HSBL-ko-gyo/WING27/README.md

# WING27

[回路図・PCBをブラウザで見る（KiCanvas）](https://kicanvas.org/?repo=https://github.com/HSBL-ko-gyo/WING27)
