HSBL-ko-gyo/WING27/reference/P2/Wing27_P2_60_key_centers_mm.dxf

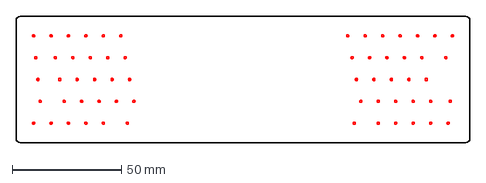
[picture p1: CAD file, 2026-10-17]
reference/P2/Wing27_P2_60_key_centers_mm.dxf
208.0 x 58.0 mm
