HSBL-ko-gyo/WING27/reference/P2/Wing27_P2_reference_plate_T1_D1_60_centers.step

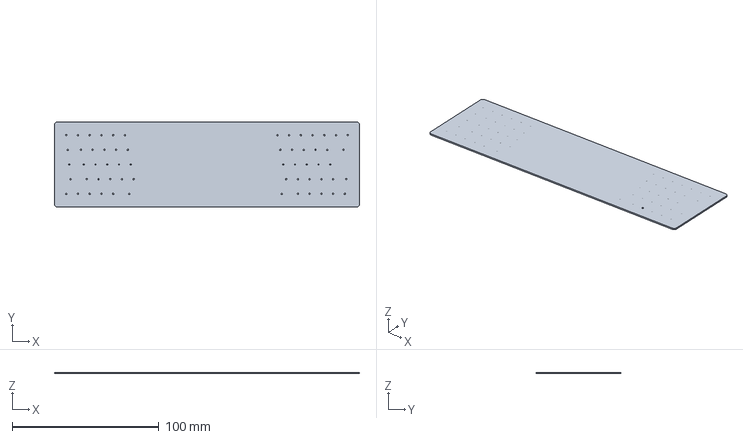
[picture p2: CAD file, 2026-10-17]
reference/P2/Wing27_P2_reference_plate_T1_D1_60_centers.step
208.0 x 58.0 x 1.00 mm
