HSBL-ko-gyo/WING27/WING27.kicad_pcb

## KiCad design WING27.kicad_pcb (2026-10-17)

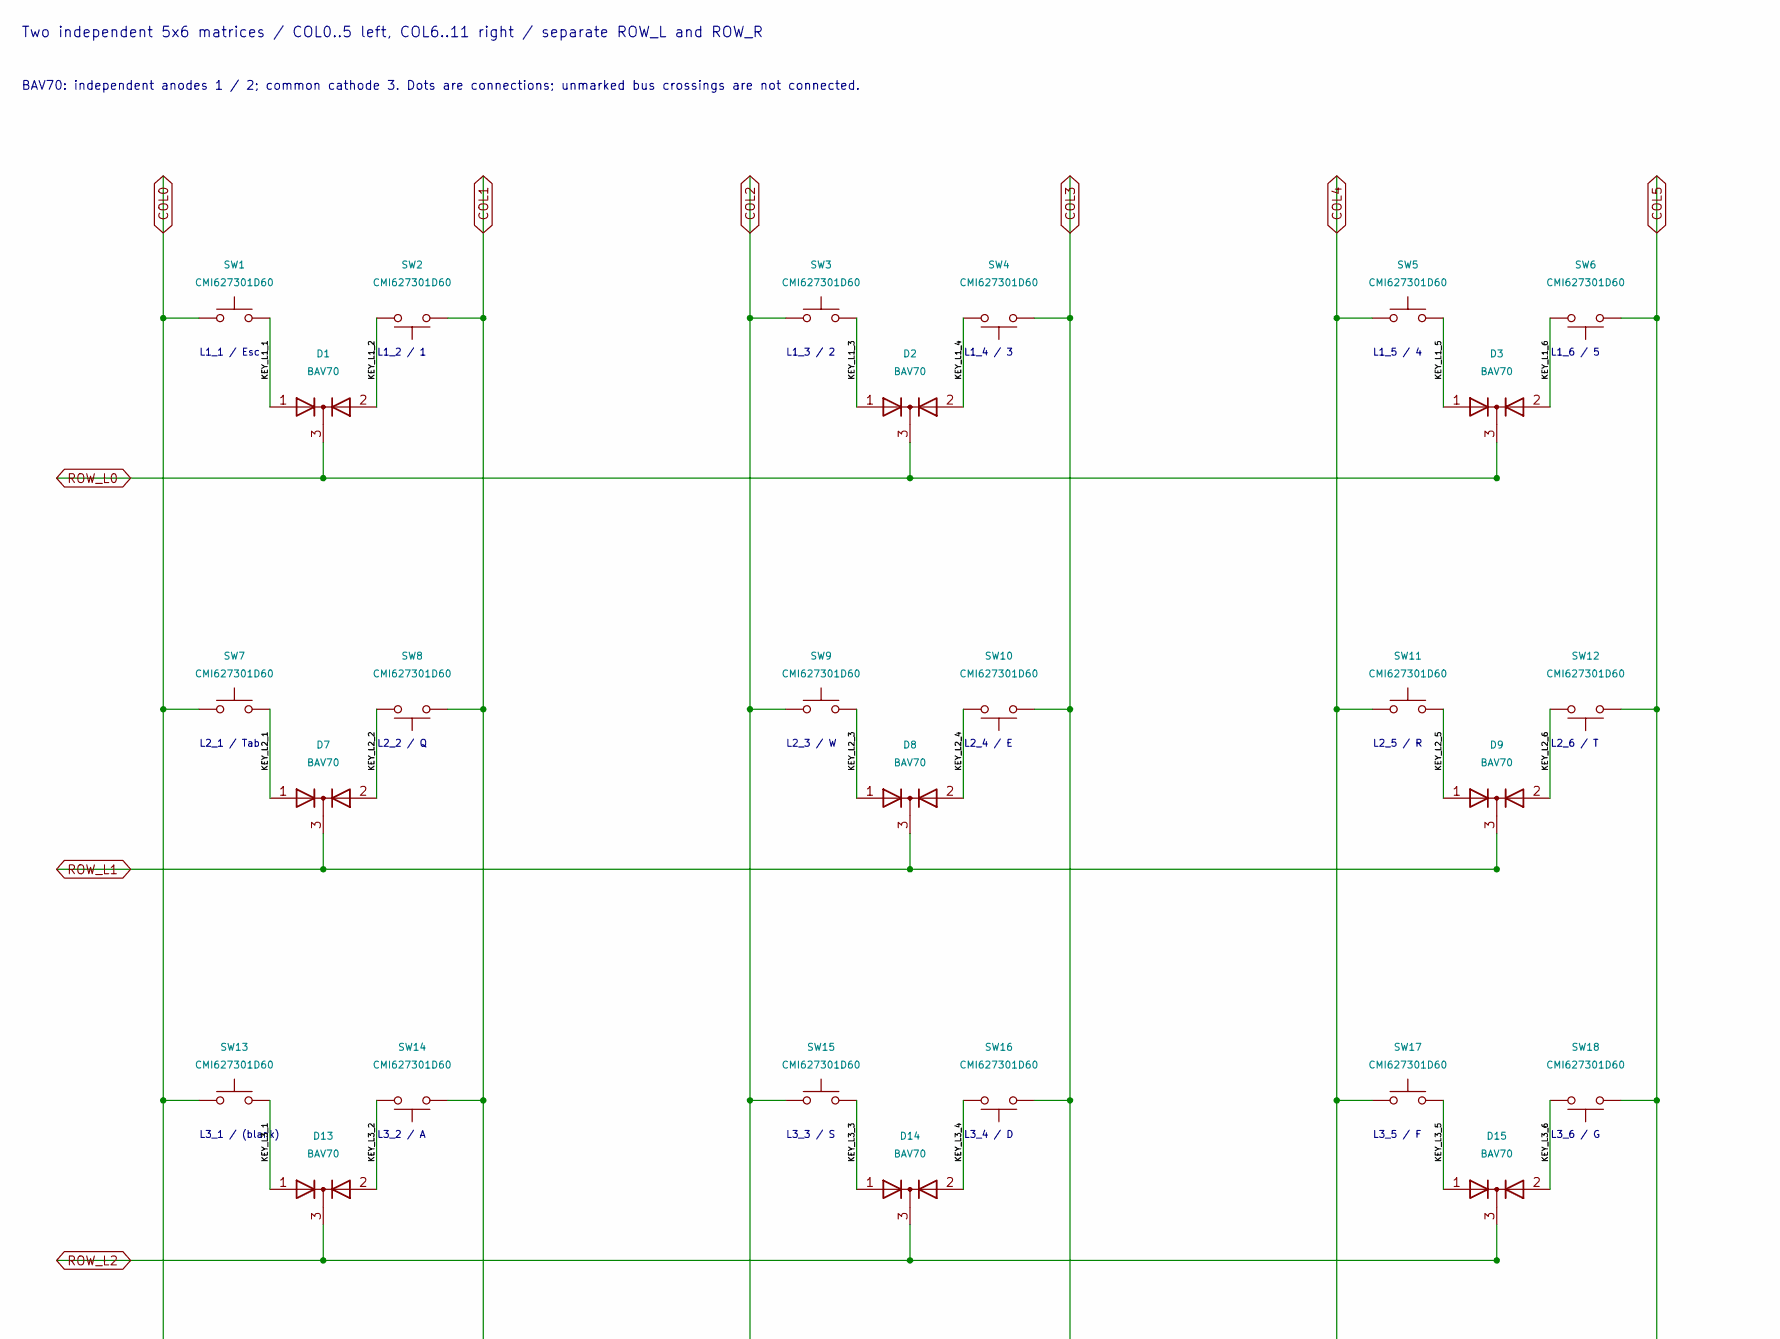
[picture p3: schematic WING27.kicad_sch, WING27 / 60-key matrix, part in row 1, column 1]

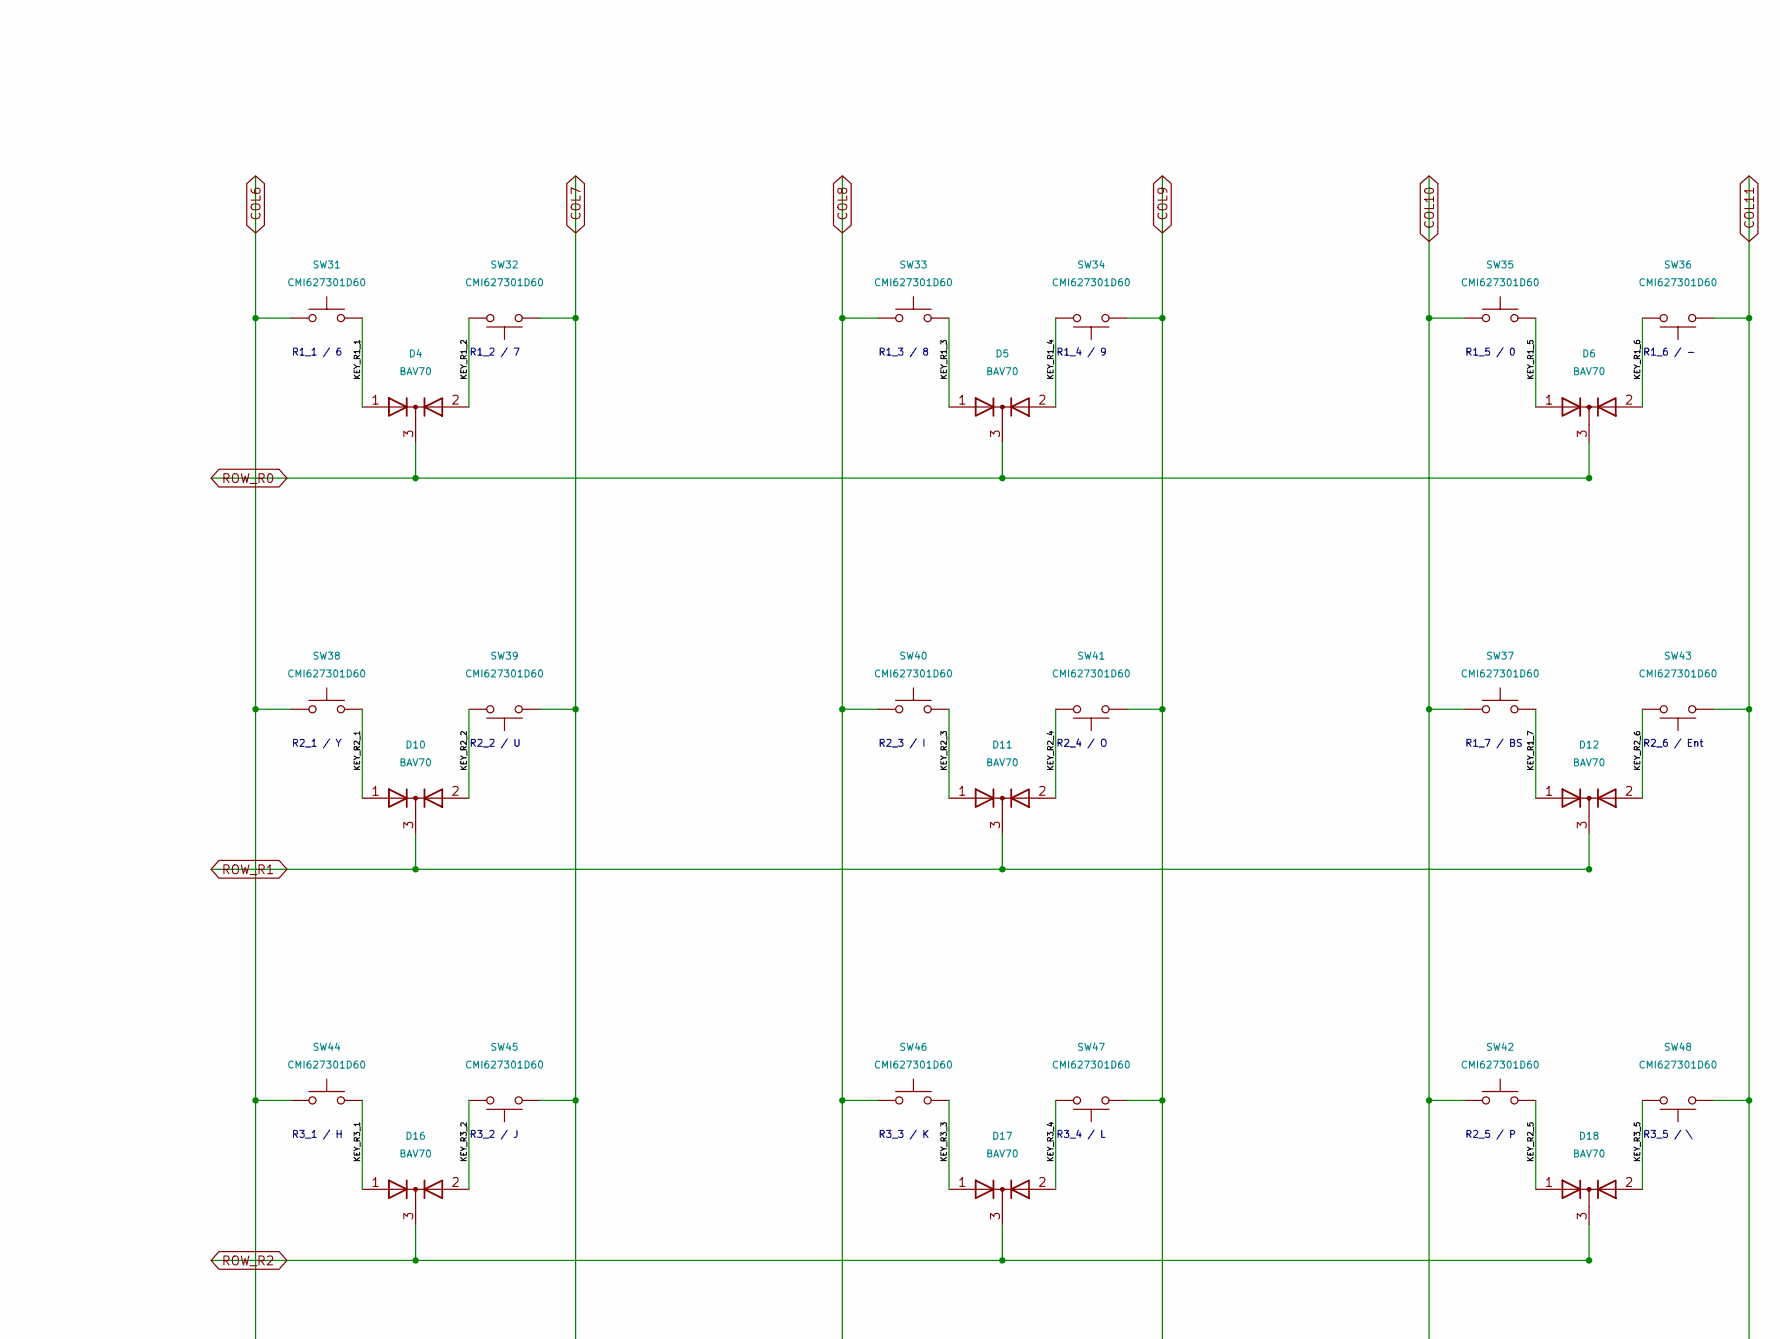
[picture p4: schematic WING27.kicad_sch, WING27 / 60-key matrix, part in row 1, column 2]

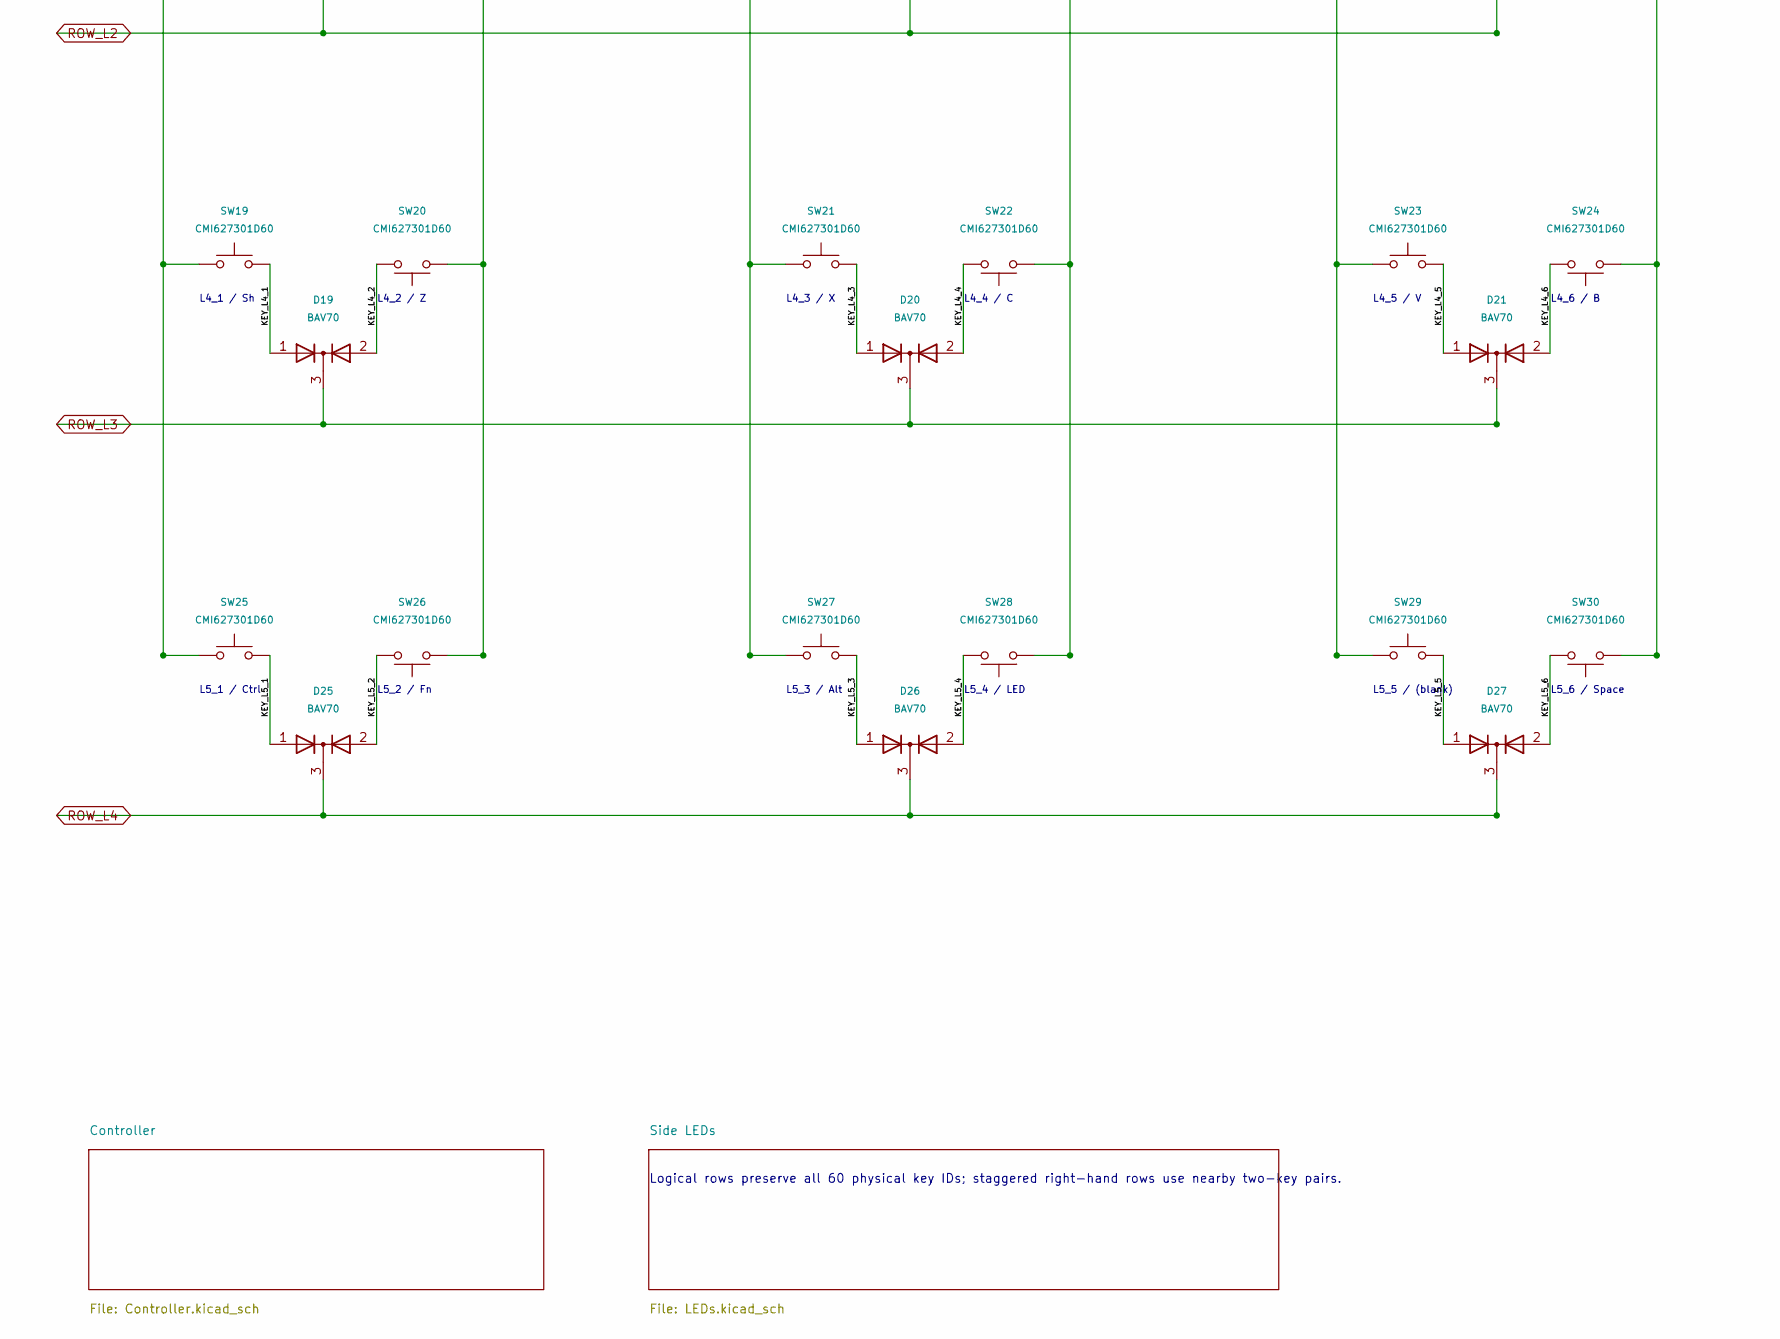
[picture p5: schematic WING27.kicad_sch, WING27 / 60-key matrix, part in row 2, column 1]

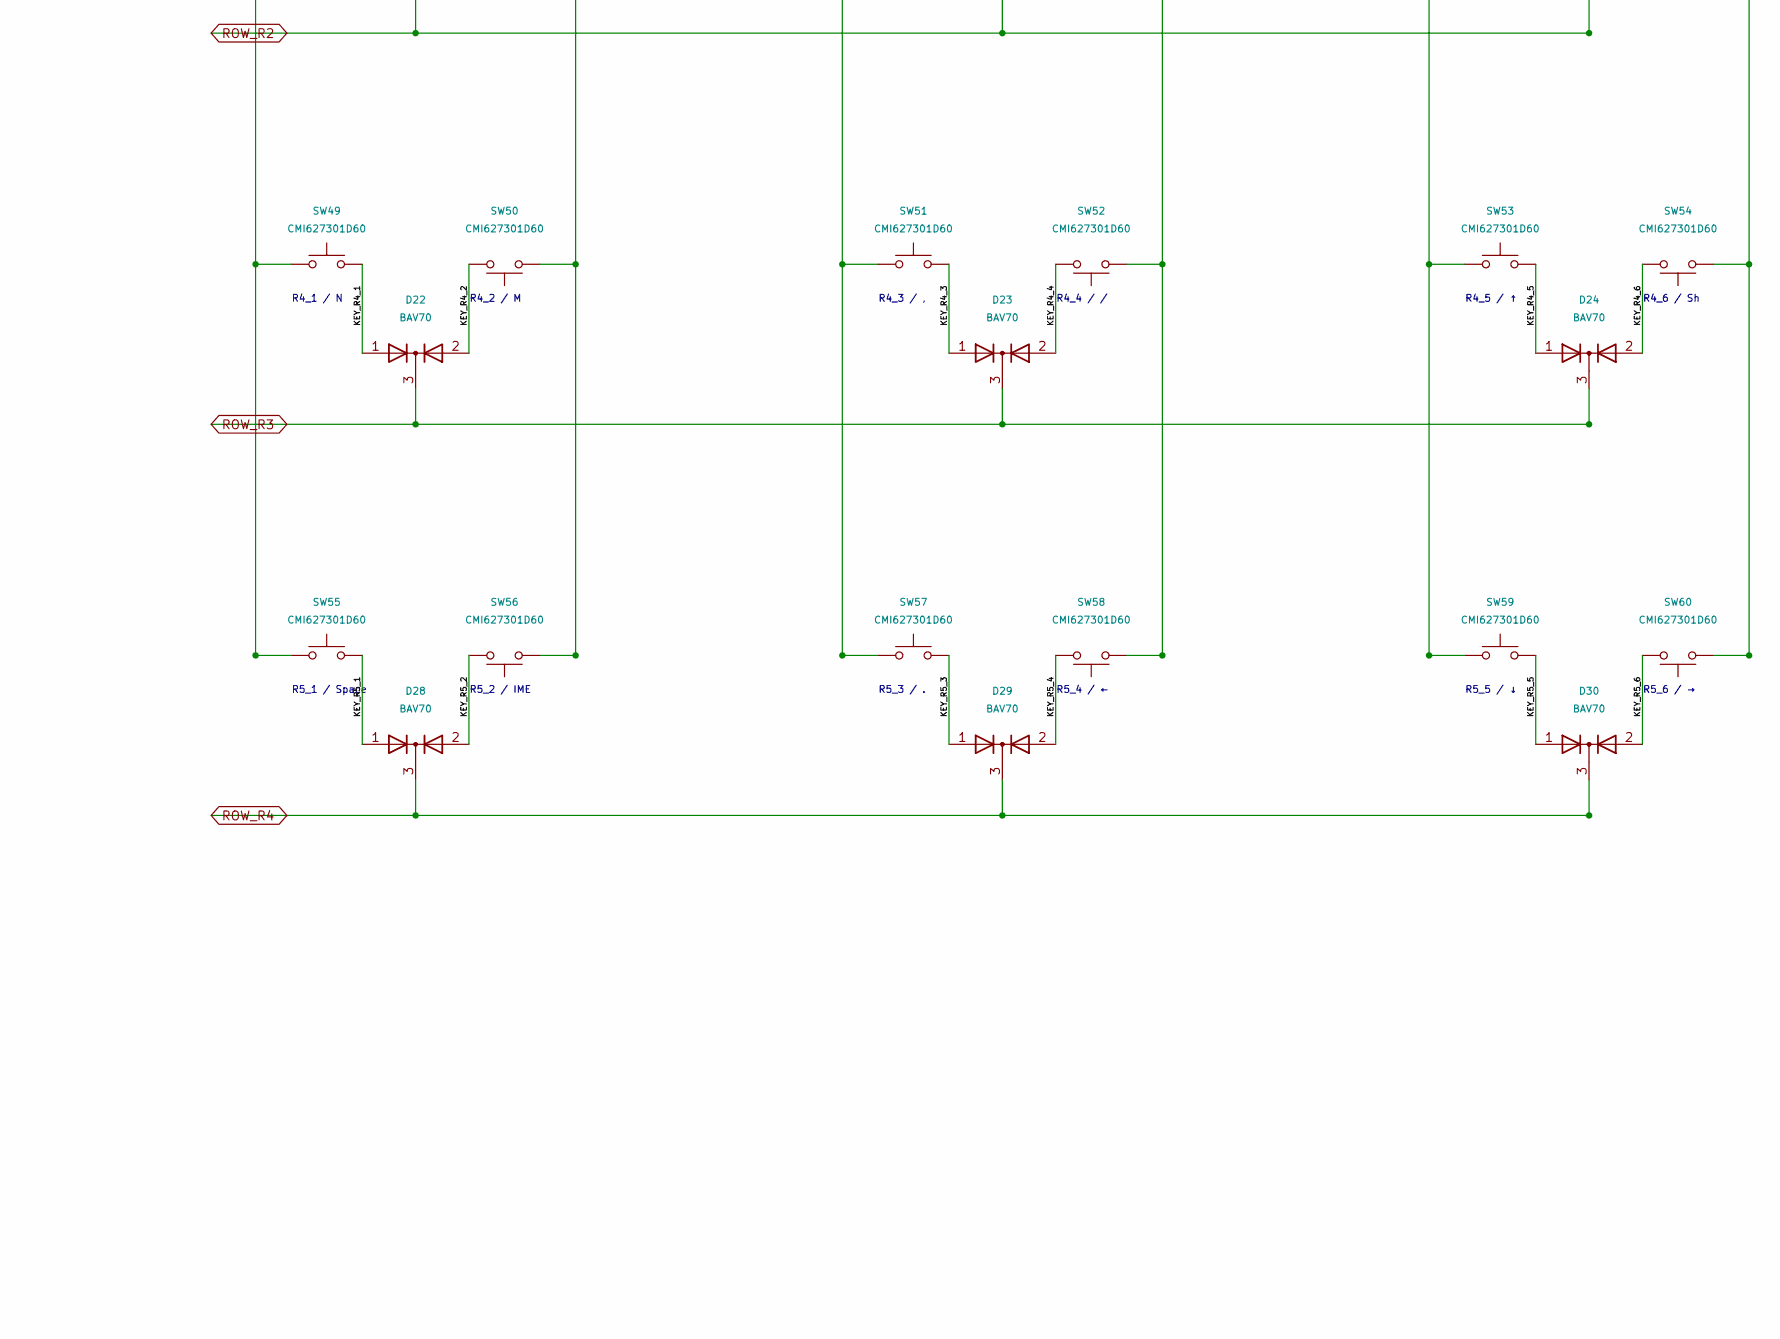
[picture p6: schematic WING27.kicad_sch, WING27 / 60-key matrix, part in row 2, column 2]

Parts:
D1, D2, D3, D4, D5, D6, D7, D8, D9, D10, D11, D12, D13, D14, D15, D16, D17, D18, D19, D20, D21, D22, D23, D24, D25, D26, D27, D28, D29, D30: BAV70; SOT-23; manufacturer_pn BAV70; LCSC C68978
SW1, SW2, SW3, SW4, SW5, SW6, SW7, SW8, SW9, SW10, SW11, SW12, SW13, SW14, SW15, SW16, SW17, SW18, SW19, SW20, SW21, SW22, SW23, SW24, SW25, SW26, SW27, SW28, SW29, SW30, SW31, SW32, SW33, SW34, SW35, SW36, SW37, SW38, SW39, SW40, SW41, SW42, SW43, SW44, SW45, SW46, SW47, SW48, SW49, SW50, SW51, SW52, SW53, SW54, SW55, SW56, SW57, SW58, SW59, SW60: CMI627301D60; Kailh_CMI627301D60; manufacturer_pn CMI627301D60

Connections:
/KEY_L1_1: D1.1 (A), SW1.2
/KEY_L1_2: D1.2 (A), SW2.2
/KEY_L1_3: D2.1 (A), SW3.2
/KEY_L1_4: D2.2 (A), SW4.2
/KEY_L1_5: D3.1 (A), SW5.2
/KEY_L1_6: D3.2 (A), SW6.2
/KEY_L2_1: D7.1 (A), SW7.2
/KEY_L2_2: D7.2 (A), SW8.2
/KEY_L2_3: D8.1 (A), SW9.2
/KEY_L2_4: D8.2 (A), SW10.2
/KEY_L2_5: D9.1 (A), SW11.2
/KEY_L2_6: D9.2 (A), SW12.2
/KEY_L3_1: D13.1 (A), SW13.2
/KEY_L3_2: D13.2 (A), SW14.2
/KEY_L3_3: D14.1 (A), SW15.2
/KEY_L3_4: D14.2 (A), SW16.2
/KEY_L3_5: D15.1 (A), SW17.2
/KEY_L3_6: D15.2 (A), SW18.2
/KEY_L4_1: D19.1 (A), SW19.2
/KEY_L4_2: D19.2 (A), SW20.2
/KEY_L4_3: D20.1 (A), SW21.2
/KEY_L4_4: D20.2 (A), SW22.2
/KEY_L4_5: D21.1 (A), SW23.2
/KEY_L4_6: D21.2 (A), SW24.2
/KEY_L5_1: D25.1 (A), SW25.2
/KEY_L5_2: D25.2 (A), SW26.2
/KEY_L5_3: D26.1 (A), SW27.2
/KEY_L5_4: D26.2 (A), SW28.2
/KEY_L5_5: D27.1 (A), SW29.2
/KEY_L5_6: D27.2 (A), SW30.2
/KEY_R1_1: D4.1 (A), SW31.2
/KEY_R1_2: D4.2 (A), SW32.2
/KEY_R1_3: D5.1 (A), SW33.2
/KEY_R1_4: D5.2 (A), SW34.2
/KEY_R1_5: D6.1 (A), SW35.2
/KEY_R1_6: D6.2 (A), SW36.2
/KEY_R1_7: D12.1 (A), SW37.2
/KEY_R2_1: D10.1 (A), SW38.2
/KEY_R2_2: D10.2 (A), SW39.2
/KEY_R2_3: D11.1 (A), SW40.2
/KEY_R2_4: D11.2 (A), SW41.2
/KEY_R2_5: D18.1 (A), SW42.2
/KEY_R2_6: D12.2 (A), SW43.2
/KEY_R3_1: D16.1 (A), SW44.2
/KEY_R3_2: D16.2 (A), SW45.2
/KEY_R3_3: D17.1 (A), SW46.2
/KEY_R3_4: D17.2 (A), SW47.2
/KEY_R3_5: D18.2 (A), SW48.2
/KEY_R4_1: D22.1 (A), SW49.2
/KEY_R4_2: D22.2 (A), SW50.2
/KEY_R4_3: D23.1 (A), SW51.2
/KEY_R4_4: D23.2 (A), SW52.2
/KEY_R4_5: D24.1 (A), SW53.2
/KEY_R4_6: D24.2 (A), SW54.2
/KEY_R5_1: D28.1 (A), SW55.2
/KEY_R5_2: D28.2 (A), SW56.2
/KEY_R5_3: D29.1 (A), SW57.2
/KEY_R5_4: D29.2 (A), SW58.2
/KEY_R5_5: D30.1 (A), SW59.2
/KEY_R5_6: D30.2 (A), SW60.2
COL0: SW1.1, SW7.1, SW13.1, SW19.1, SW25.1; also elsewhere on the board
COL1: SW2.1, SW8.1, SW14.1, SW20.1, SW26.1; also elsewhere on the board
COL2: SW3.1, SW9.1, SW15.1, SW21.1, SW27.1; also elsewhere on the board
COL3: SW4.1, SW10.1, SW16.1, SW22.1, SW28.1; also elsewhere on the board
COL4: SW5.1, SW11.1, SW17.1, SW23.1, SW29.1; also elsewhere on the board
COL5: SW6.1, SW12.1, SW18.1, SW24.1, SW30.1; also elsewhere on the board
COL6: SW31.1, SW38.1, SW44.1, SW49.1, SW55.1; also elsewhere on the board
COL7: SW32.1, SW39.1, SW45.1, SW50.1, SW56.1; also elsewhere on the board
COL8: SW33.1, SW40.1, SW46.1, SW51.1, SW57.1; also elsewhere on the board
COL9: SW34.1, SW41.1, SW47.1, SW52.1, SW58.1; also elsewhere on the board
COL10: SW35.1, SW37.1, SW42.1, SW53.1, SW59.1; also elsewhere on the board
COL11: SW36.1, SW43.1, SW48.1, SW54.1, SW60.1; also elsewhere on the board
ROW_L0: D1.3 (K), D2.3 (K), D3.3 (K); also elsewhere on the board
ROW_L1: D7.3 (K), D8.3 (K), D9.3 (K); also elsewhere on the board
ROW_L2: D13.3 (K), D14.3 (K), D15.3 (K); also elsewhere on the board
ROW_L3: D19.3 (K), D20.3 (K), D21.3 (K); also elsewhere on the board
ROW_L4: D25.3 (K), D26.3 (K), D27.3 (K); also elsewhere on the board
ROW_R0: D4.3 (K), D5.3 (K), D6.3 (K); also elsewhere on the board
ROW_R1: D10.3 (K), D11.3 (K), D12.3 (K); also elsewhere on the board
ROW_R2: D16.3 (K), D17.3 (K), D18.3 (K); also elsewhere on the board
ROW_R3: D22.3 (K), D23.3 (K), D24.3 (K); also elsewhere on the board
ROW_R4: D28.3 (K), D29.3 (K), D30.3 (K); also elsewhere on the board

Notes on the sheet:
L1_1 / Esc
L1_2 / 1
L1_3 / 2
L1_4 / 3
L1_5 / 4
L1_6 / 5
L2_1 / Tab
L2_2 / Q
L2_3 / W
L2_4 / E
L2_5 / R
L2_6 / T
L3_1 / (blank)
L3_2 / A
L3_3 / S
L3_4 / D
L3_5 / F
L3_6 / G
L4_1 / Sh
L4_2 / Z
L4_3 / X
L4_4 / C
L4_5 / V
L4_6 / B
L5_1 / Ctrl
L5_2 / Fn
L5_3 / Alt
L5_4 / LED
L5_5 / (blank)
L5_6 / Space
R1_1 / 6
R1_2 / 7
R1_3 / 8
R1_4 / 9
R1_5 / 0
R1_6 / -
R1_7 / BS
R2_1 / Y
R2_2 / U
R2_3 / I
R2_4 / O
R2_5 / P
R2_6 / Ent
R3_1 / H
R3_2 / J
R3_3 / K
R3_4 / L
R3_5 / \
R4_1 / N
R4_2 / M
R4_3 / ,
R4_4 / /
R4_5 / ↑
R4_6 / Sh
R5_1 / Space
R5_2 / IME
R5_3 / .
R5_4 / ←
R5_5 / ↓
R5_6 / →
Two independent 5x6 matrices / COL0..5 left, COL6..11 right / separate ROW_L and ROW_R
BAV70: independent anodes 1 / 2; common cathode 3. Dots are connections; unmarked bus crossings are not connected.
Logical rows preserve all 60 physical key IDs; staggered right-hand rows use nearby two-key pairs.

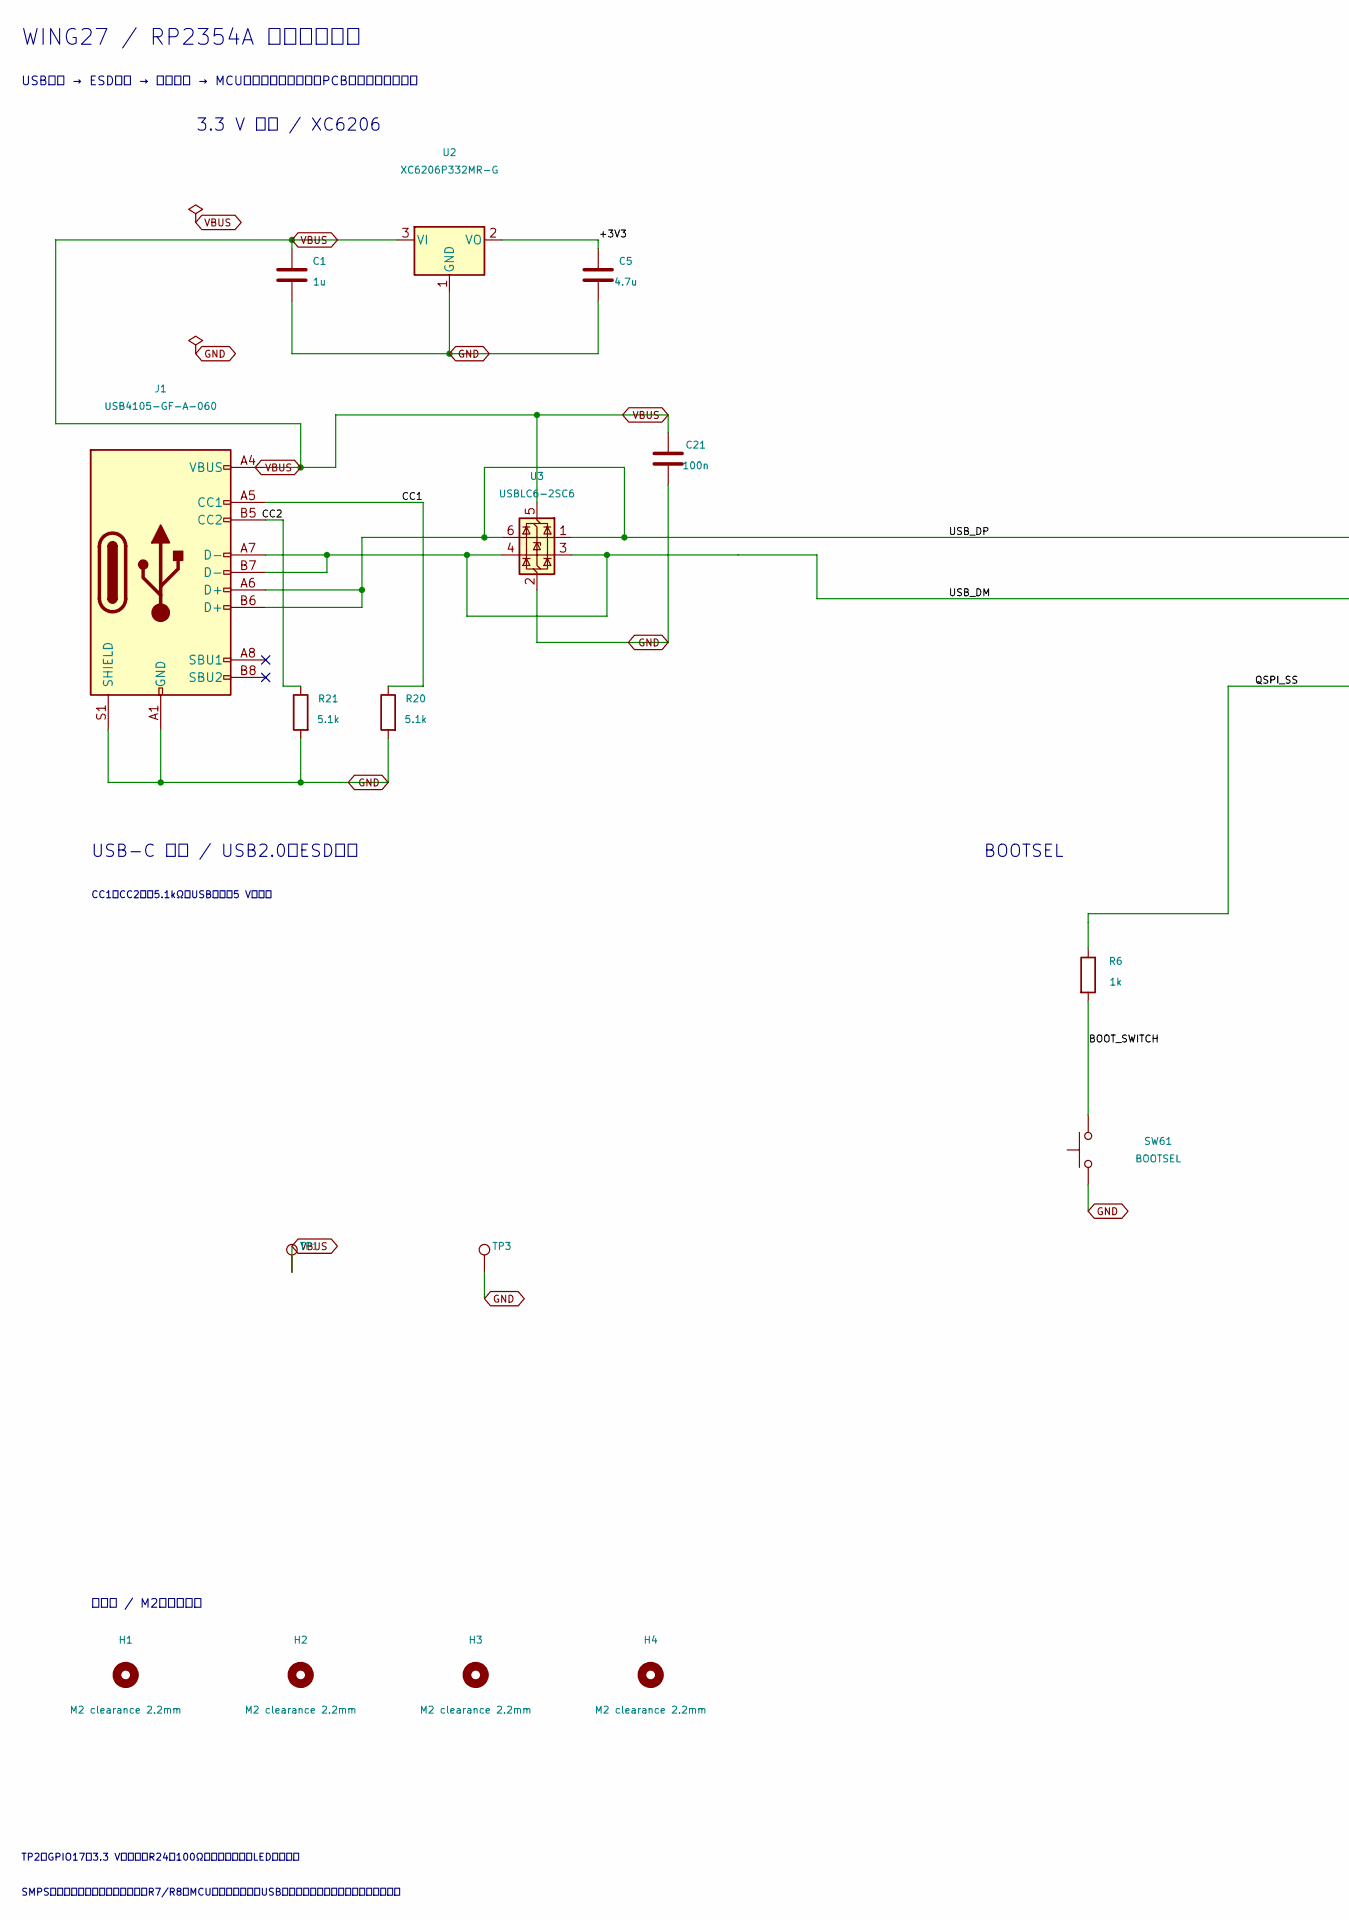
[picture p7: schematic Controller.kicad_sch, WING27 / RP2354A / USB-C controller, part in row 1, column 1]

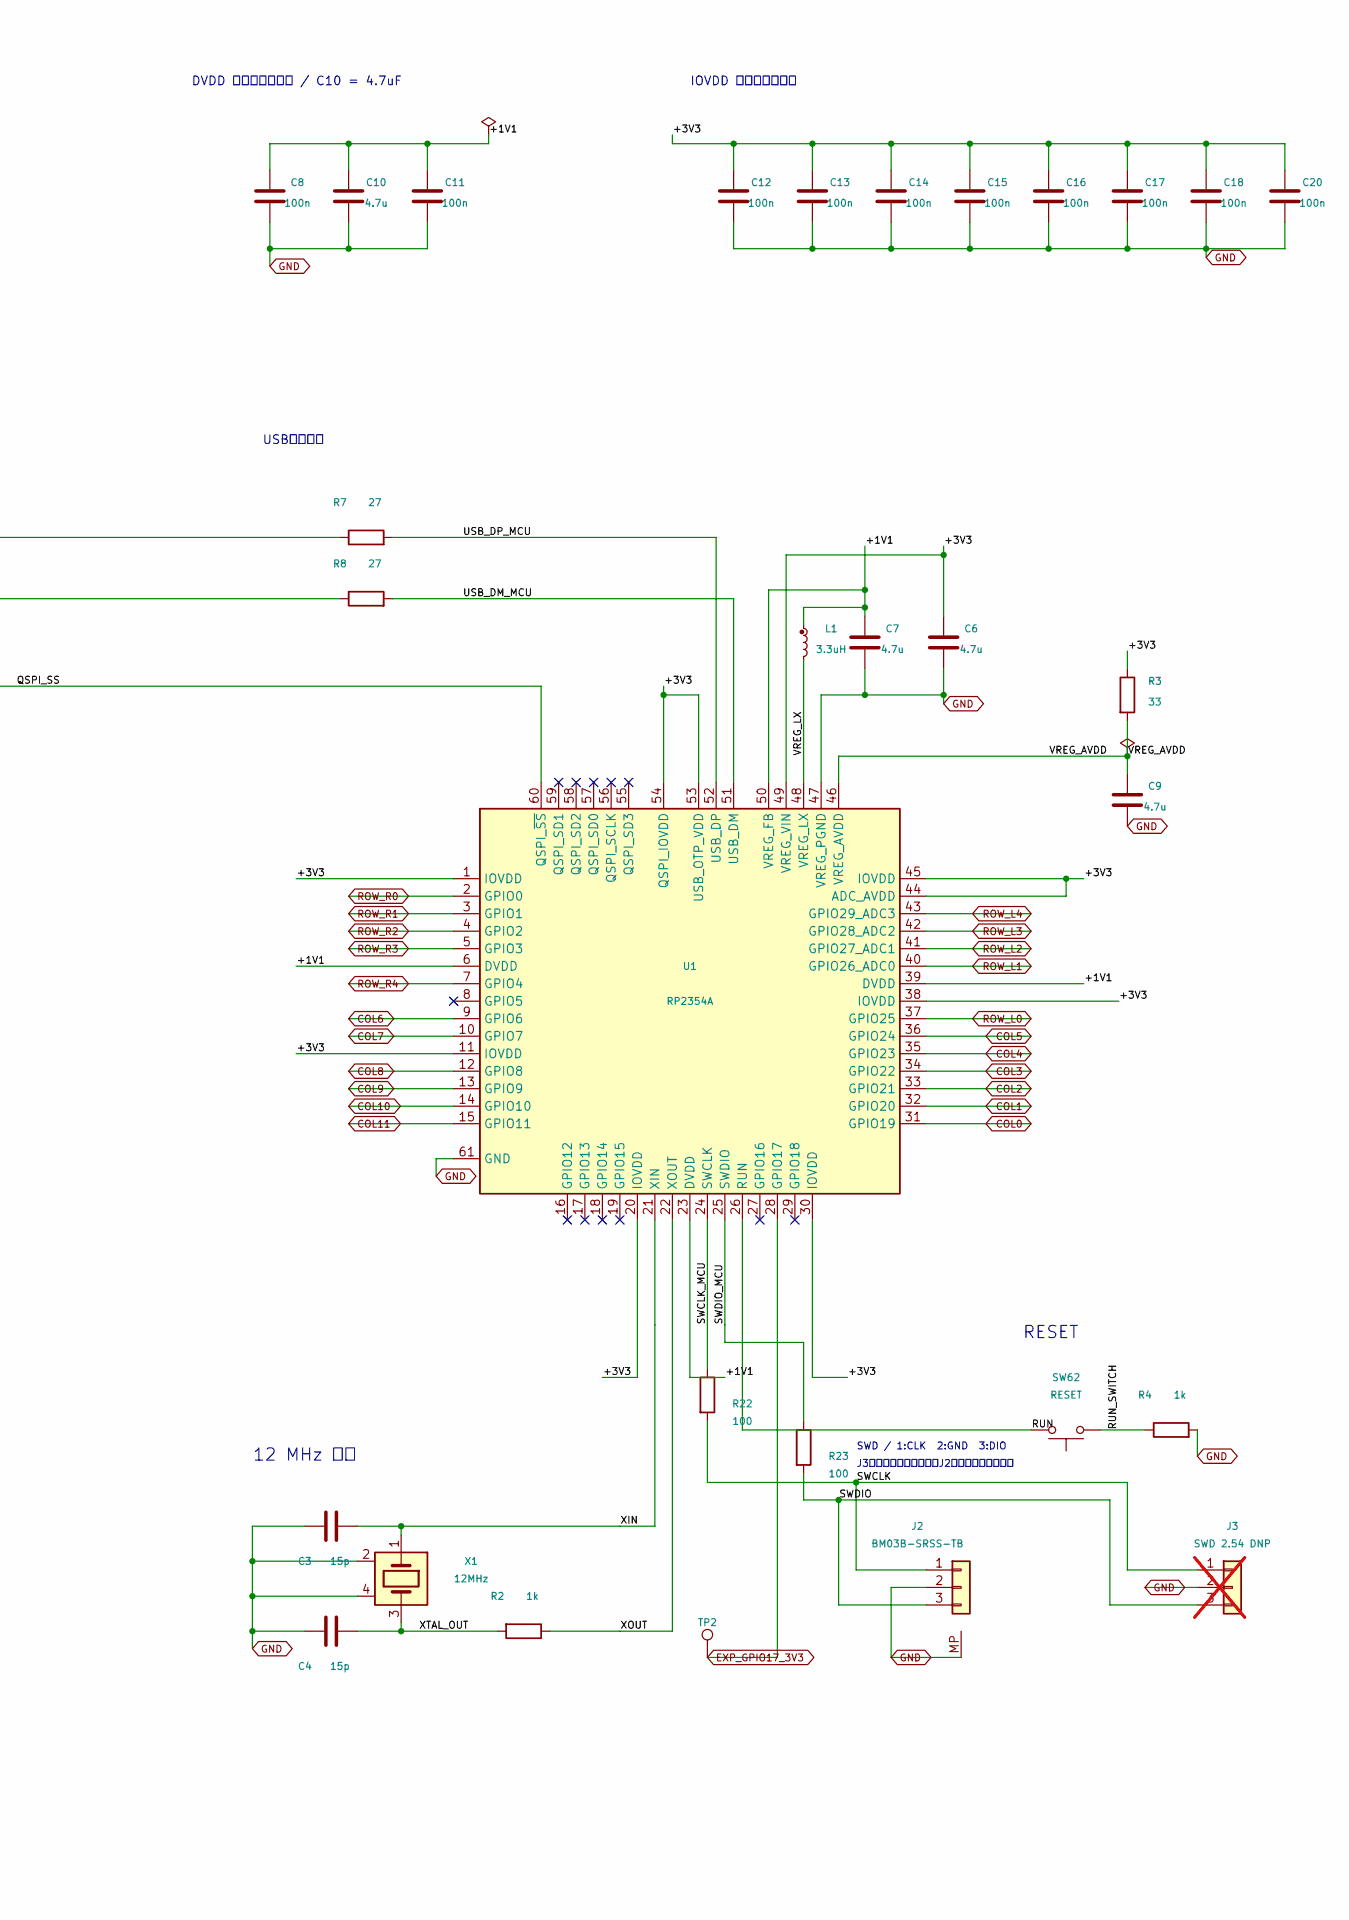
[picture p8: schematic Controller.kicad_sch, WING27 / RP2354A / USB-C controller, part in row 1, column 2]

Parts:
C1: 1u; C_0603_1608Metric; manufacturer_pn CL10A105KB8NNNC; LCSC C15849
C3, C4: 15p; RPI_generic_capc1005x50; voltage 50V; tolerance 5%; manufacturer_pn GRM1555C1H150JA01D
C5: 4.7u; C_0603_1608Metric; manufacturer_pn CL10A475KO8NNNC; LCSC C19666
C6, C7: 4.7u; RPI_generic_capc1005x50_wide; voltage 6.3V; tolerance 20%; manufacturer_pn GRM155R60J475ME47D
C8, C11, C12, C13, C14, C15, C16, C17, C18, C20, C21: 100n; RPI_generic_capc1005x50; voltage 25V; tolerance 10%; manufacturer_pn GRM155R71E104KE14D
C9, C10: 4.7u; RPI_generic_capc1005x50; voltage 6.3V; tolerance 20%; manufacturer_pn GRM155R60J475ME47D
H1, H2, H3, H4: M2 clearance 2.2mm; MountingHole_2.2mm_M2
J1: USB4105-GF-A-060; USB_C_GCT_USB4105_GF_A060_JLC; manufacturer_pn USB4105-GF-A-060; LCSC C3025063
J2: BM03B-SRSS-TB; JST_SH_BM03B-SRSS-TB_1x03-1MP_P1.00mm_Vertical; manufacturer_pn BM03B-SRSS-TB(LF)(SN); LCSC C5306067
J3: SWD 2.54 DNP; PinHeader_1x03_P2.54mm_Vertical; not fitted
L1: 3.3uH; RPI_abracon_aota-b201610s3r3-101-t; tolerance 20%; manufacturer_pn AOTA-B201610S3R3-101-T
R2, R4, R6: 1k; RPI_generic_resc1005x35; tolerance 1%; voltage 50V; manufacturer_pn RC0402FR-071KL
R3: 33; RPI_generic_resc1005x35; tolerance 1%; voltage 50V; manufacturer_pn RC0402FR-0733RL
R7, R8: 27; RPI_generic_resc1005x35; tolerance 1%; voltage 50V; manufacturer_pn RC0402FR-0727RL
R20, R21: 5.1k; RPI_generic_resc1005x35; manufacturer_pn RC0402FR-075K1L
R22, R23: 100; RPI_generic_resc1005x35; manufacturer_pn RC0402FR-07100RL
SW61: BOOTSEL; SW_SPST_TS-1088-AR02016; manufacturer_pn TS-1088-AR02016; LCSC C720477
SW62: RESET; SW_SPST_TS-1088-AR02016; manufacturer_pn TS-1088-AR02016; LCSC C720477
TP1: VBUS; TestPoint_Pad_D1.5mm
TP2: EXP_GPIO17_3V3; TestPoint_Pad_D1.5mm
TP3: GND; TestPoint_Pad_D1.5mm
U1: RP2354A; RPI_rpi_rp2350a_vias; manufacturer_pn RP2354A
U2: XC6206P332MR-G; XC6206_SOT23_Torex_Reference; manufacturer_pn XC6206P332MR-G; LCSC C5446
U3: USBLC6-2SC6; SOT-23-6; manufacturer_pn USBLC6-2SC6; LCSC C7519
X1: 12MHz; RPI_generic_xtalcc320x250x80-4; tolerance 30ppm; manufacturer_pn ABM8-272-T3

Connections:
/Controller/+1V1: C7.1, C8.1, C10.1, C11.1, L1.1, U1.6 (DVDD), U1.23 (DVDD), U1.39 (DVDD), U1.50 (VREG_FB)
/Controller/+3V3: C5.1, C6.1, C12.1, C13.1, C14.1, C15.1, C16.1, C17.1, C18.1, C20.1, R3.1, U1.1 (IOVDD), U1.11 (IOVDD), U1.20 (IOVDD), U1.30 (IOVDD), U1.38 (IOVDD), U1.44 (ADC_AVDD), U1.45 (IOVDD), U1.49 (VREG_VIN), U1.53 (USB_OTP_VDD), U1.54 (QSPI_IOVDD), U2.2 (VO)
/Controller/BOOT_SWITCH: R6.2, SW61.2
/Controller/CC1: J1.A5 (CC1), R20.1
/Controller/CC2: J1.B5 (CC2), R21.1
/Controller/QSPI_SS: R6.1, U1.60 (QSPI_~SS)
/Controller/RUN: SW62.2, U1.26 (RUN)
/Controller/RUN_SWITCH: R4.1, SW62.1
/Controller/SWCLK: J2.1, J3.1, R22.2
/Controller/SWCLK_MCU: R22.1, U1.24 (SWCLK)
/Controller/SWDIO: J2.3, J3.3, R23.2
/Controller/SWDIO_MCU: R23.1, U1.25 (SWDIO)
/Controller/USB_DM: J1.A7 (D-), J1.B7 (D-), R8.1, U3.3 (I/O2), U3.4 (I/O2)
/Controller/USB_DM_MCU: R8.2, U1.51 (USB_DM)
/Controller/USB_DP: J1.A6 (D+), J1.B6 (D+), R7.1, U3.1 (I/O1), U3.6 (I/O1)
/Controller/USB_DP_MCU: R7.2, U1.52 (USB_DP)
/Controller/VREG_AVDD: C9.1, R3.2, U1.46 (VREG_AVDD)
/Controller/VREG_LX: L1.2, U1.48 (VREG_LX)
/Controller/XIN: C3.1, U1.21 (XIN), X1.1
/Controller/XOUT: R2.1, U1.22 (XOUT)
/Controller/XTAL_OUT: C4.1, R2.2, X1.3
COL0: U1.31 (GPIO19); also elsewhere on the board
COL1: U1.32 (GPIO20); also elsewhere on the board
COL2: U1.33 (GPIO21); also elsewhere on the board
COL3: U1.34 (GPIO22); also elsewhere on the board
COL4: U1.35 (GPIO23); also elsewhere on the board
COL5: U1.36 (GPIO24); also elsewhere on the board
COL6: U1.9 (GPIO6); also elsewhere on the board
COL7: U1.10 (GPIO7); also elsewhere on the board
COL8: U1.12 (GPIO8); also elsewhere on the board
COL9: U1.13 (GPIO9); also elsewhere on the board
COL10: U1.14 (GPIO10); also elsewhere on the board
COL11: U1.15 (GPIO11); also elsewhere on the board
EXP_GPIO17_3V3: TP2.1, U1.28 (GPIO17); also elsewhere on the board
GND: C1.2, C3.2, C4.2, C5.2, C6.2, C7.2, C8.2, C9.2, C10.2, C11.2, C12.2, C13.2, C14.2, C15.2, C16.2, C17.2, C18.2, C20.2, C21.2, J1.A1 (GND), J1.A12 (GND), J1.B1 (GND), J1.B12 (GND), J1.S1 (SHIELD), J2.2, J2.MP, J3.2, R4.2, R20.2, R21.2, SW61.1, TP3.1, U1.47 (VREG_PGND), U1.61 (GND), U2.1 (GND), U3.2 (GND), X1.2, X1.4; also elsewhere on the board
ROW_L0: U1.37 (GPIO25); also elsewhere on the board
ROW_L1: U1.40 (GPIO26_ADC0); also elsewhere on the board
ROW_L2: U1.41 (GPIO27_ADC1); also elsewhere on the board
ROW_L3: U1.42 (GPIO28_ADC2); also elsewhere on the board
ROW_L4: U1.43 (GPIO29_ADC3); also elsewhere on the board
ROW_R0: U1.2 (GPIO0); also elsewhere on the board
ROW_R1: U1.3 (GPIO1); also elsewhere on the board
ROW_R2: U1.4 (GPIO2); also elsewhere on the board
ROW_R3: U1.5 (GPIO3); also elsewhere on the board
ROW_R4: U1.7 (GPIO4); also elsewhere on the board
VBUS: C1.1, C21.1, J1.A4 (VBUS), J1.A9 (VBUS), J1.B4 (VBUS), J1.B9 (VBUS), TP1.1, U2.3 (VI), U3.5 (VBUS); also elsewhere on the board

Notes on the sheet:
WING27 / RP2354A コントローラ
USB入力 → ESD保護 → 直列抵抗 → MCU。電気接続・部品・PCB配置は変更なし。
3.3 V 電源 / XC6206
DVDD デカップリング / C10 = 4.7uF
IOVDD デカップリング
USB-C 入力 / USB2.0・ESD保護
CC1・CC2は各5.1kΩ。USB給電は5 Vのみ。
USB直列抵抗
BOOTSEL
12 MHz 水晶
RESET
SWD / 1:CLK 2:GND 3:DIO
J3は未実装の代替端子。J2と同時接続しない。
取付穴 / M2・非めっき
TP2：GPIO17の3.3 Vデータ。R24（100Ω）経由でサイドLEDを駆動。
SMPS・水晶は公式配置関係を維持。R7/R8はMCUの近くに配置。USB・発熱・突入電流は実機検証が必要。
