HSBL-ko-gyo/WING27/WING27.kicad_pcb

## KiCad design WING27.kicad_pcb (continued)

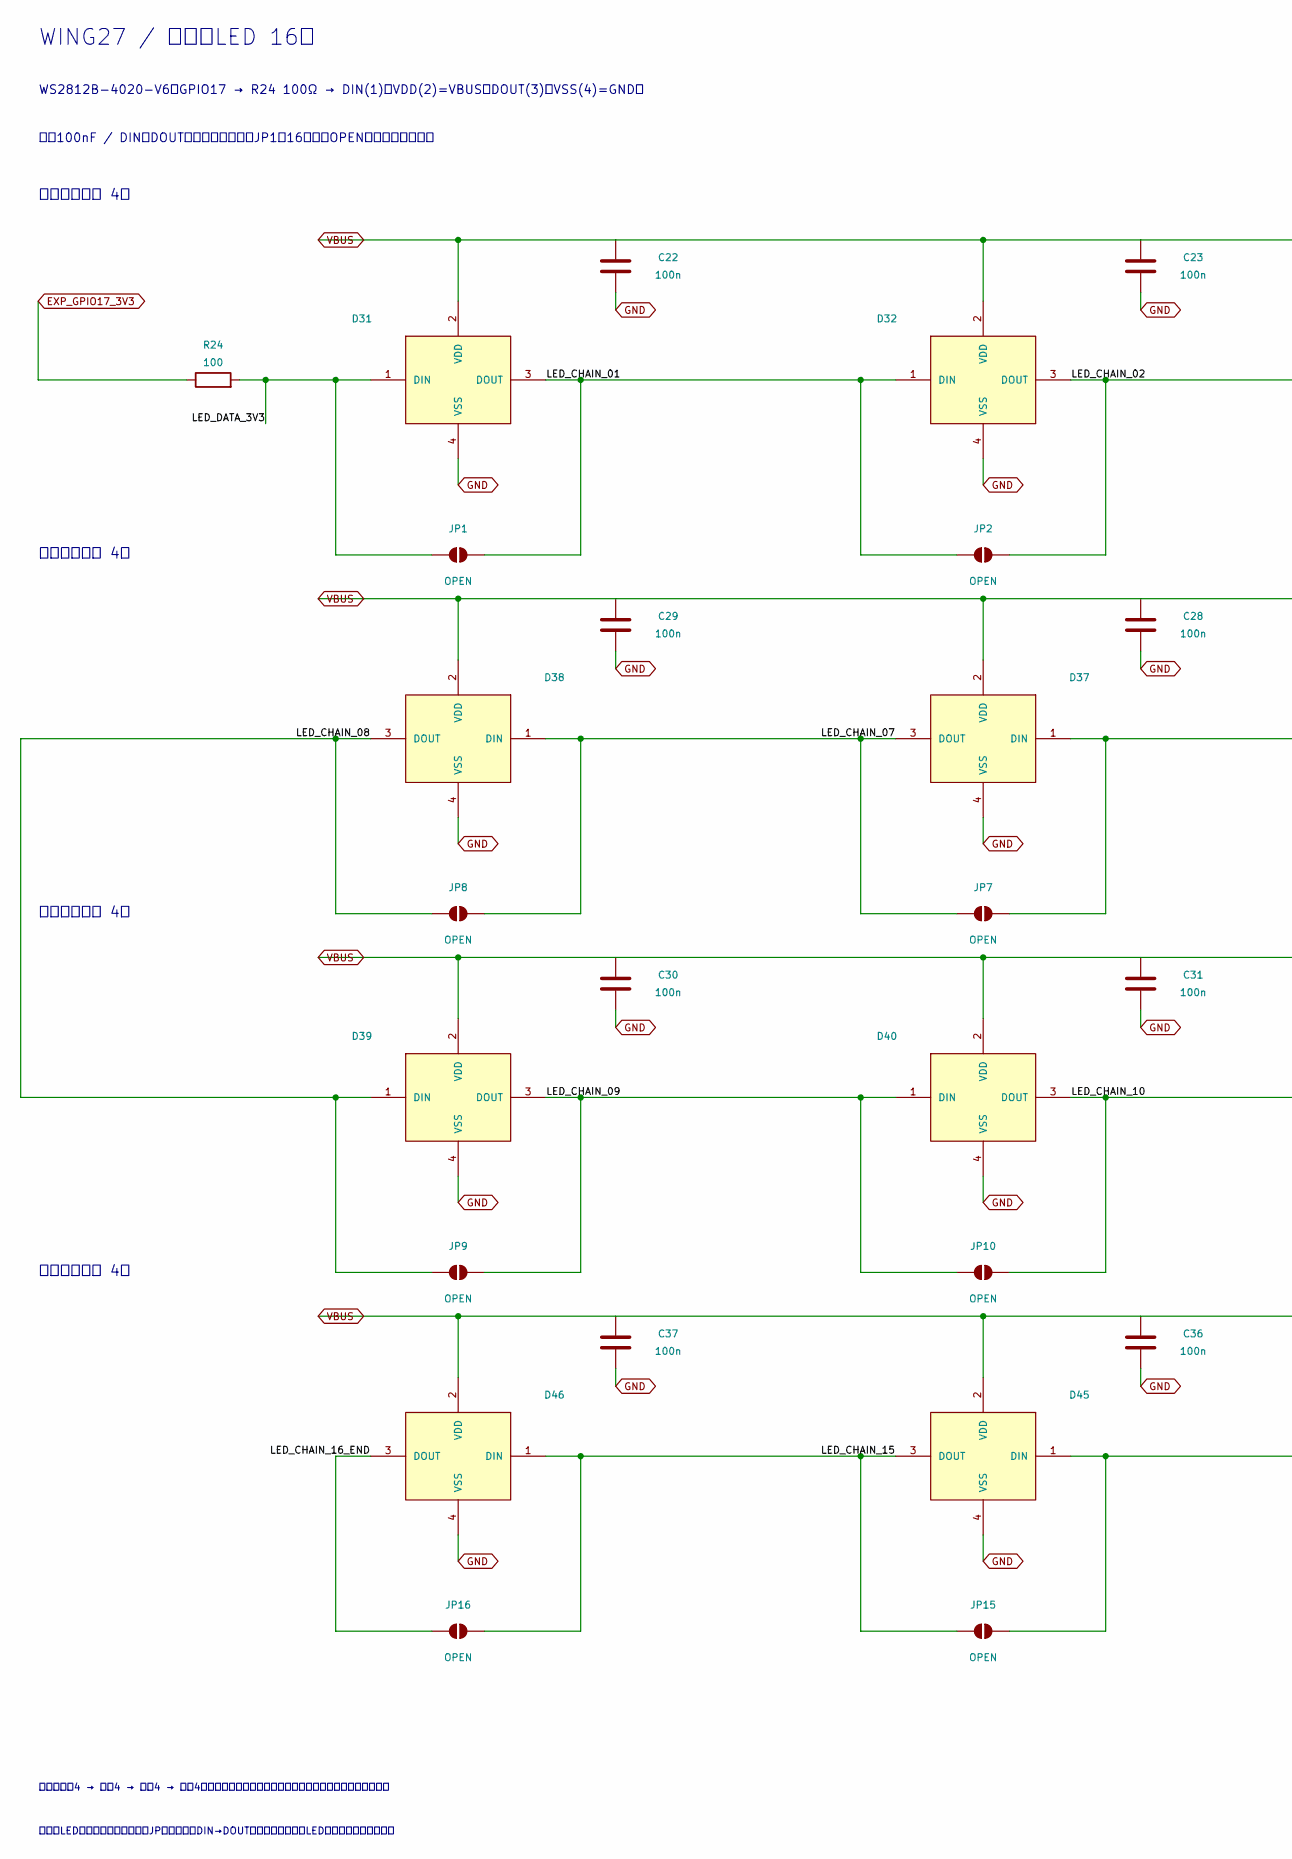
[picture p9: schematic LEDs.kicad_sch, WING27 / サイドLED 16灯, part in row 1, column 1]

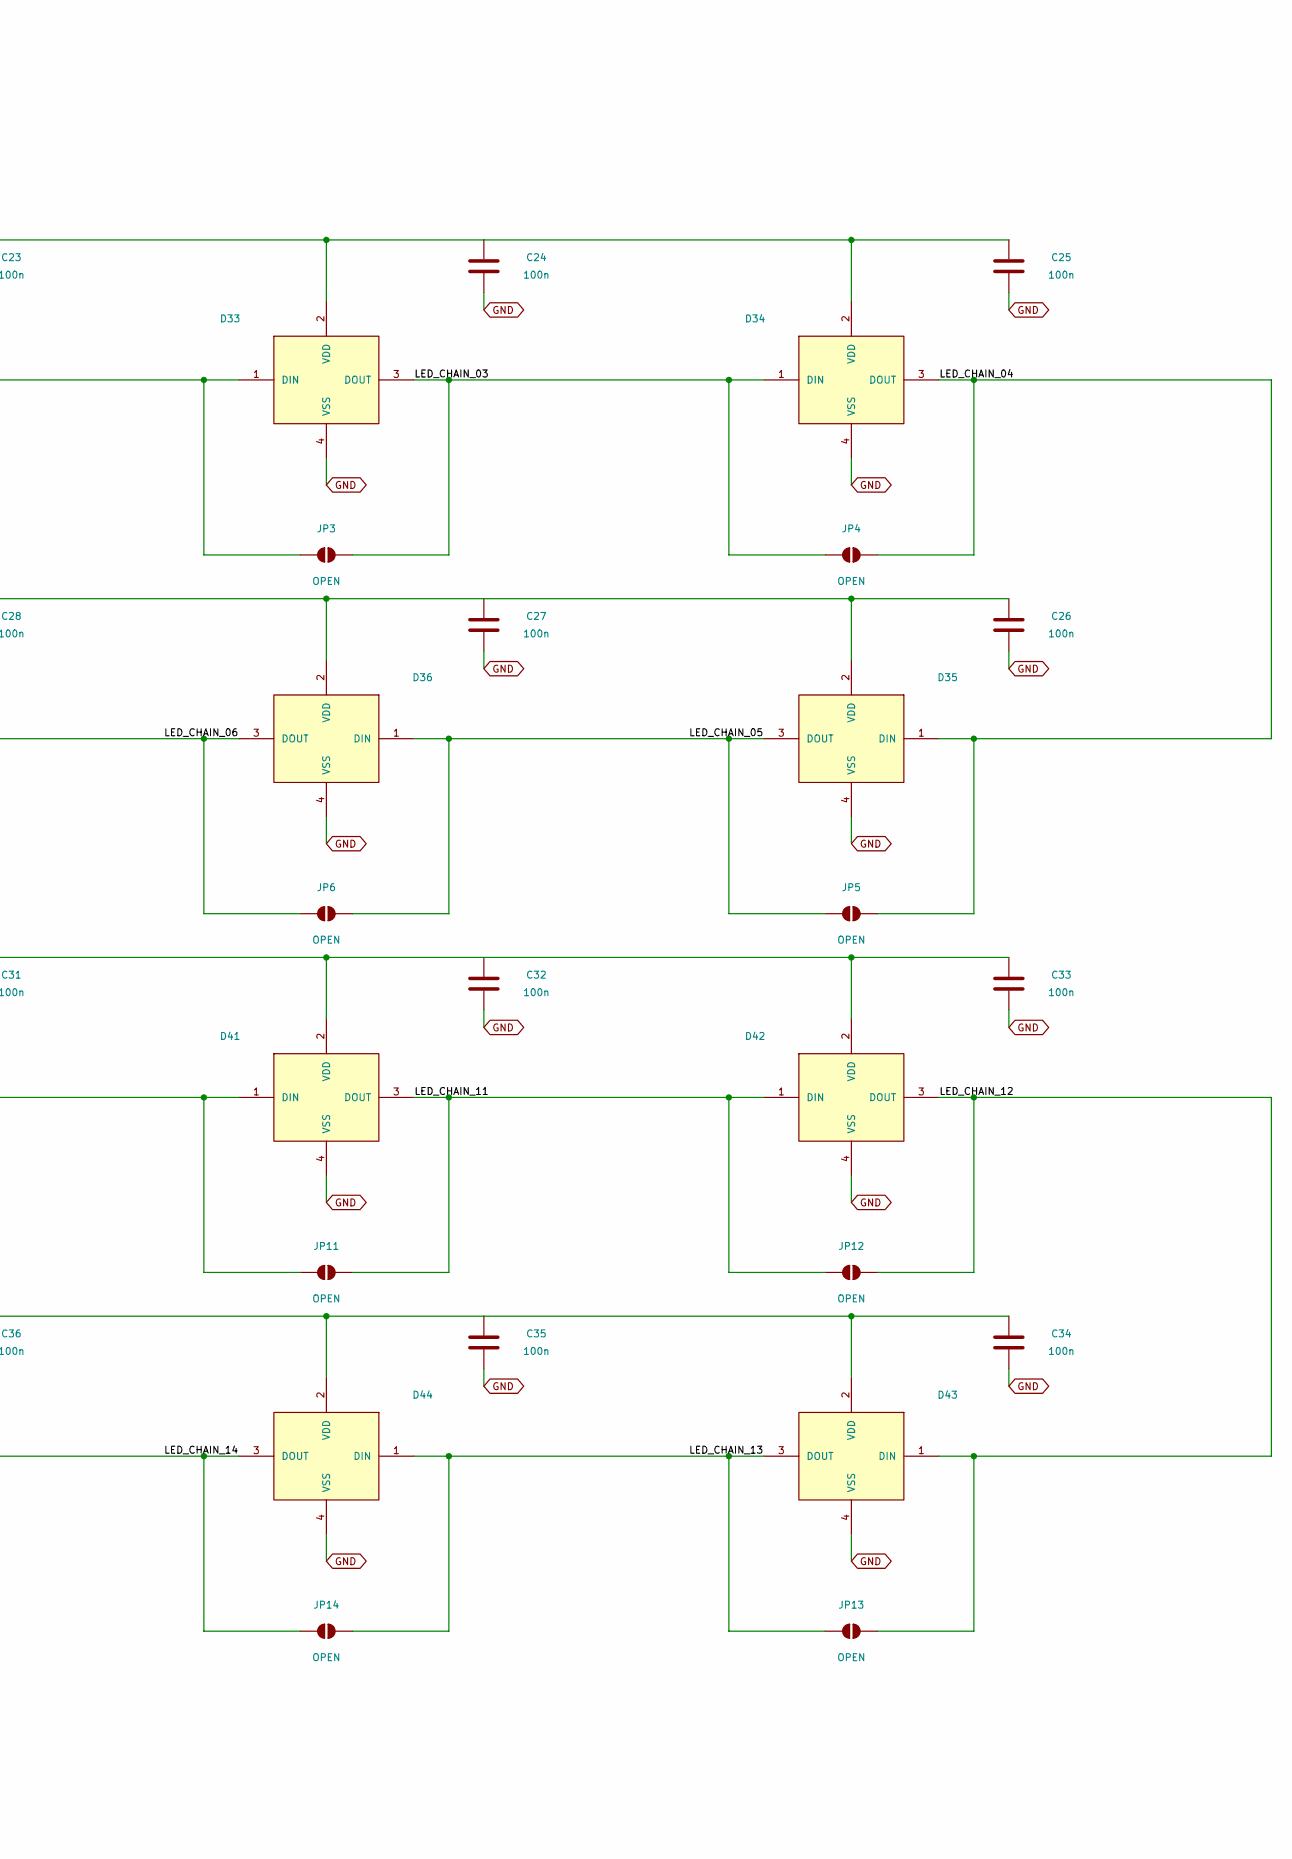
[picture p10: schematic LEDs.kicad_sch, WING27 / サイドLED 16灯, part in row 1, column 2]

Parts:
C22, C23, C24, C25, C26, C27, C28, C29, C30, C31, C32, C33, C34, C35, C36, C37: 100n; RPI_generic_capc1005x50; voltage 25V; tolerance 10%; manufacturer_pn GRM155R71E104KE14D
D31, D32, D33, D34, D35, D36, D37, D38, D39, D40, D41, D42, D43, D44, D45, D46: WS2812B-4020-V6; WS2812B_4020_V6_LCSC_Reference; manufacturer_pn WS2812B-4020-V6; LCSC C52941387
JP1, JP2, JP3, JP4, JP5, JP6, JP7, JP8, JP9, JP10, JP11, JP12, JP13, JP14, JP15, JP16: OPEN; SolderJumper-2_P1.3mm_Open_Pad1.0x1.5mm
R24: 100; RPI_generic_resc1005x35; manufacturer_pn RC0402FR-07100RL

Connections:
/Side LEDs/LED_CHAIN_01: D31.3 (DOUT), D32.1 (DIN), JP1.2 (B), JP2.1 (A)
/Side LEDs/LED_CHAIN_02: D32.3 (DOUT), D33.1 (DIN), JP2.2 (B), JP3.1 (A)
/Side LEDs/LED_CHAIN_03: D33.3 (DOUT), D34.1 (DIN), JP3.2 (B), JP4.1 (A)
/Side LEDs/LED_CHAIN_04: D34.3 (DOUT), D35.1 (DIN), JP4.2 (B), JP5.1 (A)
/Side LEDs/LED_CHAIN_05: D35.3 (DOUT), D36.1 (DIN), JP5.2 (B), JP6.1 (A)
/Side LEDs/LED_CHAIN_06: D36.3 (DOUT), D37.1 (DIN), JP6.2 (B), JP7.1 (A)
/Side LEDs/LED_CHAIN_07: D37.3 (DOUT), D38.1 (DIN), JP7.2 (B), JP8.1 (A)
/Side LEDs/LED_CHAIN_08: D38.3 (DOUT), D39.1 (DIN), JP8.2 (B), JP9.1 (A)
/Side LEDs/LED_CHAIN_09: D39.3 (DOUT), D40.1 (DIN), JP9.2 (B), JP10.1 (A)
/Side LEDs/LED_CHAIN_10: D40.3 (DOUT), D41.1 (DIN), JP10.2 (B), JP11.1 (A)
/Side LEDs/LED_CHAIN_11: D41.3 (DOUT), D42.1 (DIN), JP11.2 (B), JP12.1 (A)
/Side LEDs/LED_CHAIN_12: D42.3 (DOUT), D43.1 (DIN), JP12.2 (B), JP13.1 (A)
/Side LEDs/LED_CHAIN_13: D43.3 (DOUT), D44.1 (DIN), JP13.2 (B), JP14.1 (A)
/Side LEDs/LED_CHAIN_14: D44.3 (DOUT), D45.1 (DIN), JP14.2 (B), JP15.1 (A)
/Side LEDs/LED_CHAIN_15: D45.3 (DOUT), D46.1 (DIN), JP15.2 (B), JP16.1 (A)
/Side LEDs/LED_CHAIN_16_END: D46.3 (DOUT), JP16.2 (B)
/Side LEDs/LED_DATA_3V3: D31.1 (DIN), JP1.1 (A), R24.2
EXP_GPIO17_3V3: R24.1; also elsewhere on the board
GND: C22.2, C23.2, C24.2, C25.2, C26.2, C27.2, C28.2, C29.2, C30.2, C31.2, C32.2, C33.2, C34.2, C35.2, C36.2, C37.2, D31.4 (VSS), D32.4 (VSS), D33.4 (VSS), D34.4 (VSS), D35.4 (VSS), D36.4 (VSS), D37.4 (VSS), D38.4 (VSS), D39.4 (VSS), D40.4 (VSS), D41.4 (VSS), D42.4 (VSS), D43.4 (VSS), D44.4 (VSS), D45.4 (VSS), D46.4 (VSS); also elsewhere on the board
VBUS: C22.1, C23.1, C24.1, C25.1, C26.1, C27.1, C28.1, C29.1, C30.1, C31.1, C32.1, C33.1, C34.1, C35.1, C36.1, C37.1, D31.2 (VDD), D32.2 (VDD), D33.2 (VDD), D34.2 (VDD), D35.2 (VDD), D36.2 (VDD), D37.2 (VDD), D38.2 (VDD), D39.2 (VDD), D40.2 (VDD), D41.2 (VDD), D42.2 (VDD), D43.2 (VDD), D44.2 (VDD), D45.2 (VDD), D46.2 (VDD); also elsewhere on the board

Notes on the sheet:
左側・内向き 4灯
左側・外向き 4灯
右側・内向き 4灯
右側・外向き 4灯
WING27 / サイドLED 16灯
WS2812B-4020-V6：GPIO17 → R24 100Ω → DIN(1)。VDD(2)=VBUS、DOUT(3)、VSS(4)=GND。
各灯100nF / DIN・DOUTは実配線で連鎖。JP1〜16は通常OPEN、部品実装不要。
順序：左内4 → 左外4 → 右内4 → 右外4。図の左右は信号順を示す。基板の光向きは実装図で確認。
途中のLEDを外す場合のみ、対応JPを短絡してDIN→DOUTをバイパスする。LED実装中は短絡しない。

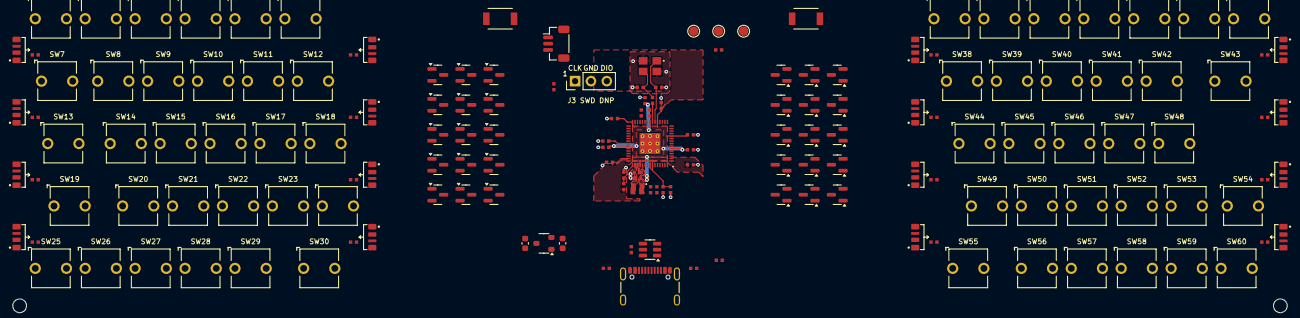
[picture p11: board WING27.kicad_pcb from above]

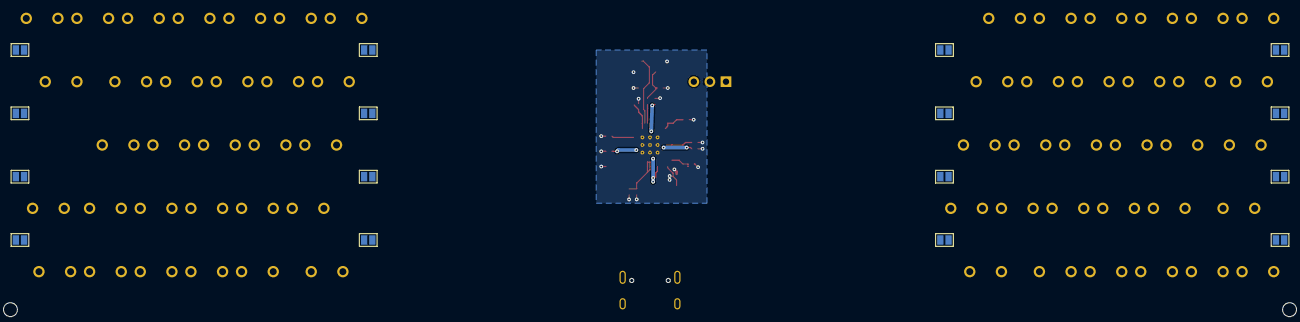
[picture p12: board WING27.kicad_pcb from below]

Board: 2 copper layers, 185 parts (16 on the bottom side), 123 nets.
