HSBL-ko-gyo/WING27/reference/RaspberryPi/RPI-RP2350A-MINIMAL_R4-S1.kicad_pcb

## KiCad design reference/RaspberryPi/RPI-RP2350A-MINIMAL_R4-S1.kicad_pcb (2026-10-17)

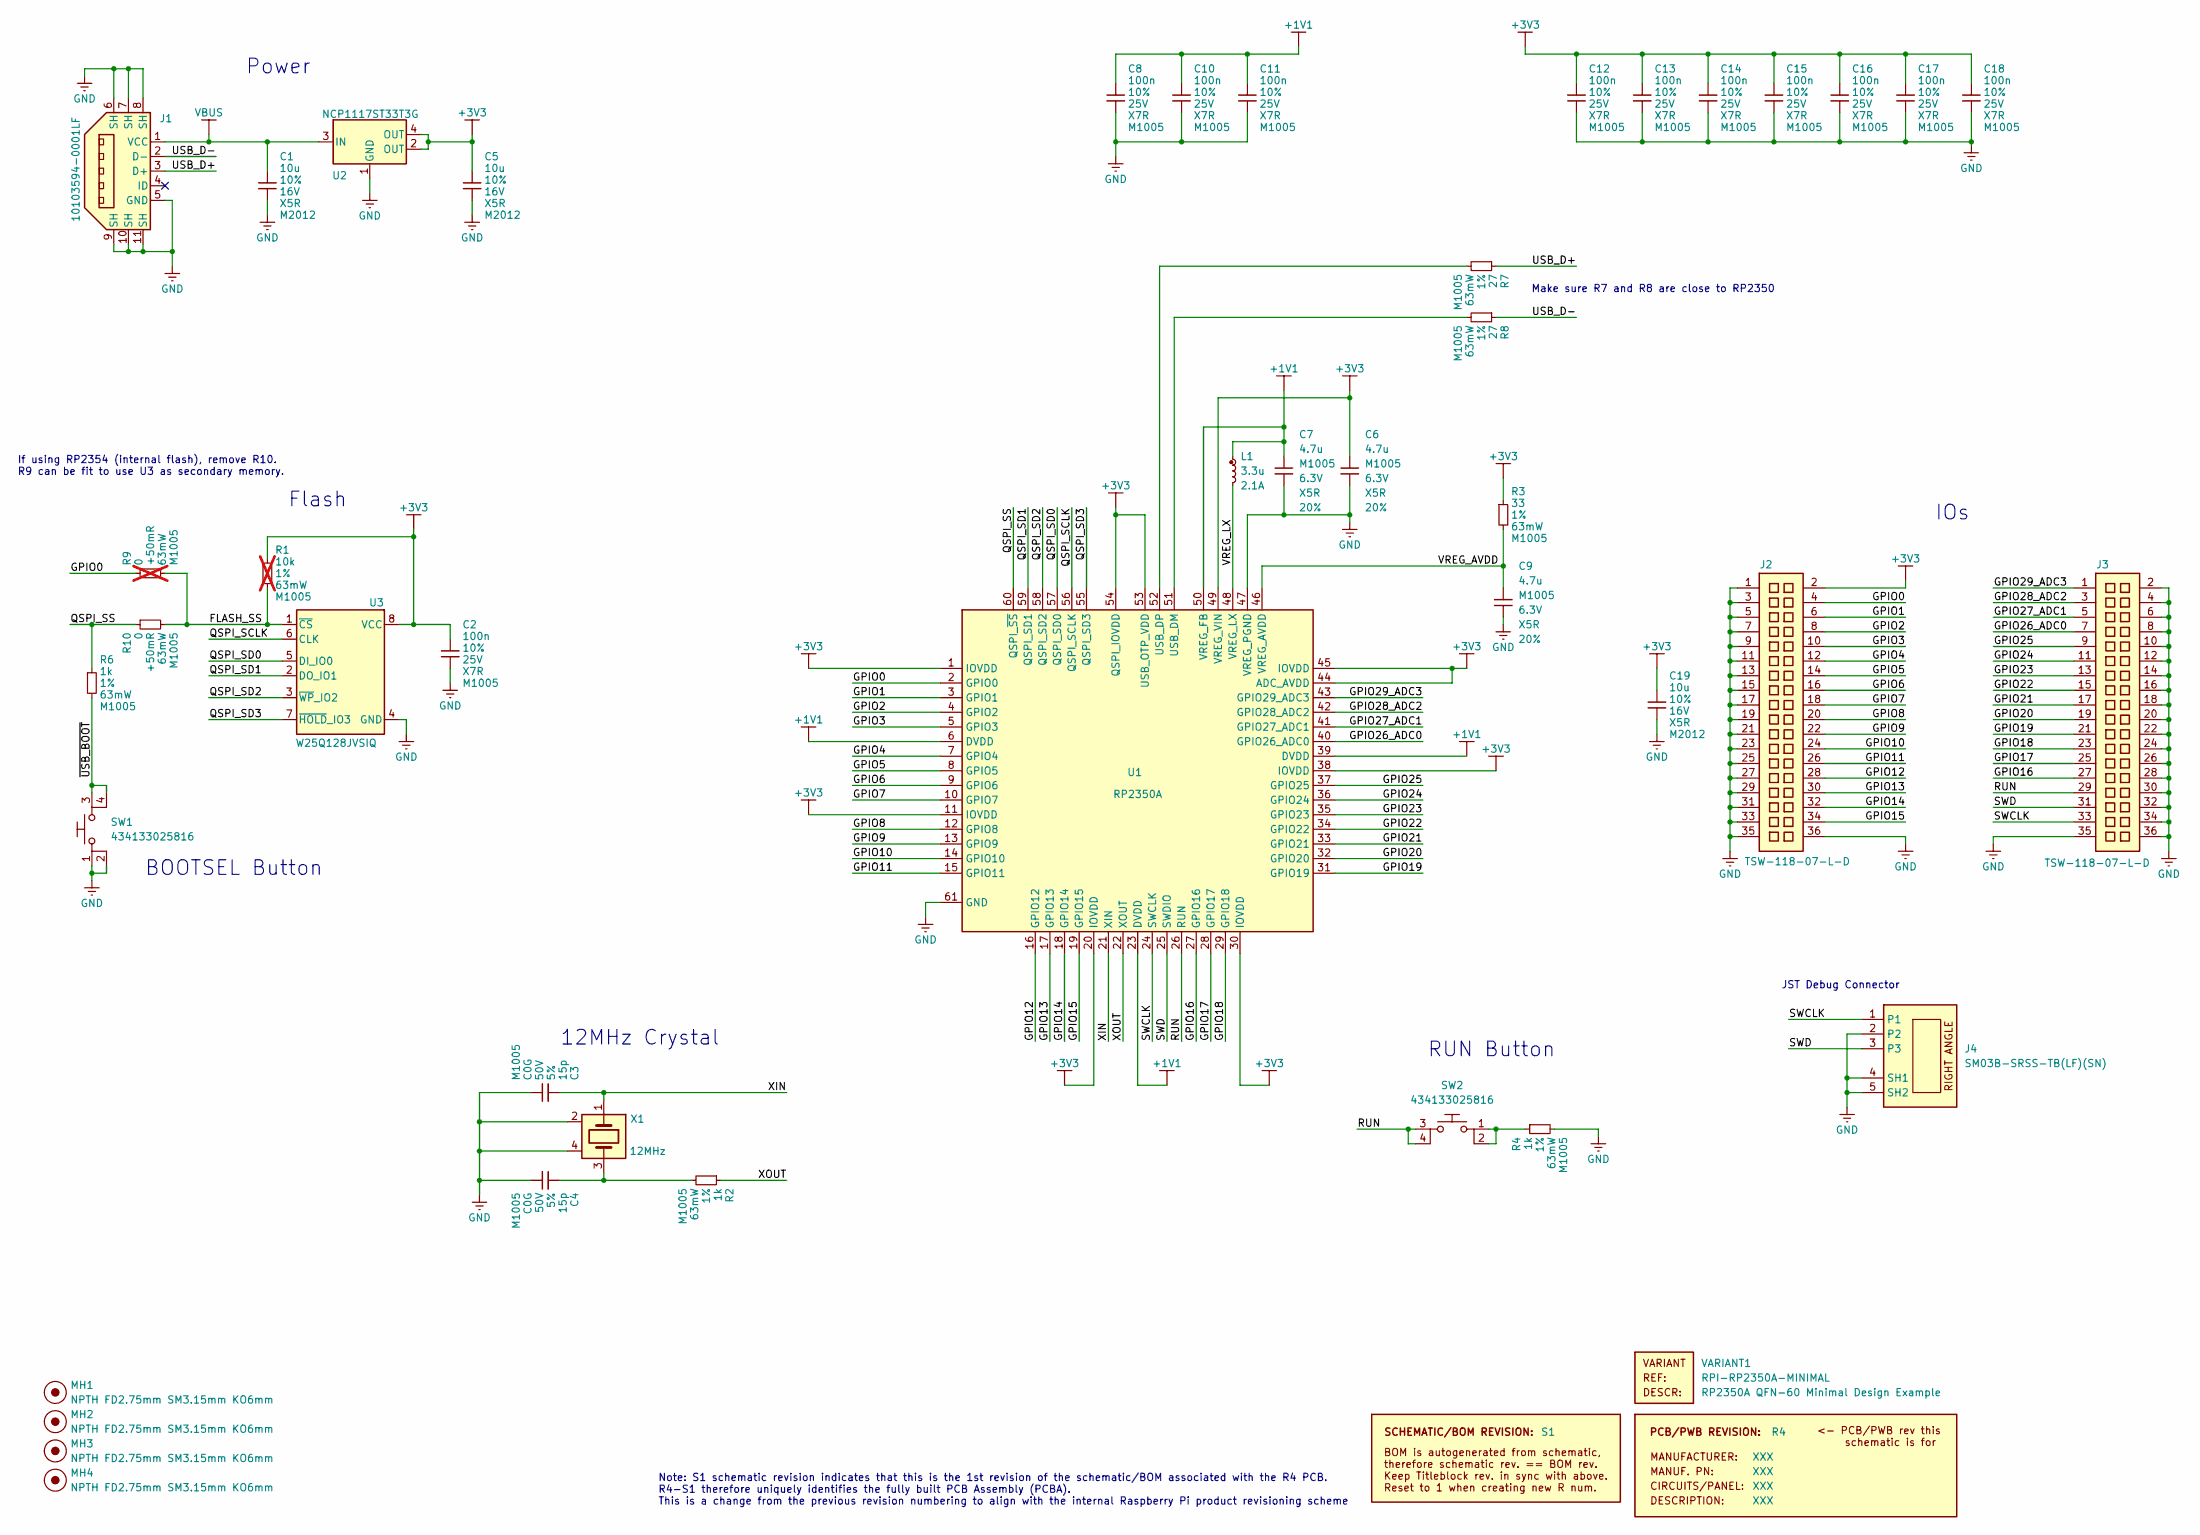
[picture p13: schematic RPI-RP2350A-MINIMAL_R4-S1.kicad_sch, RP2350A QFN-60 Minimal Design Example]

Parts:
C1, C5, C19: 10u; generic_capc2012x125; voltage 16V; tolerance 10%; part_uid RP-01GYSK-AVBE41
C2, C8, C10, C11, C12, C13, C14, C15, C16, C17, C18: 100n; generic_capc1005x50; voltage 25V; tolerance 10%; part_uid RP-01BJ9Y-KRGF41
C3, C4: 15p; generic_capc1005x50; voltage 50V; tolerance 5%; part_uid RP-01C89W-LLY9XV
C6, C7: 4.7u; generic_capc1005x50_wide; voltage 6.3V; tolerance 20%; part_uid RP-019A1P-0C2GHY
C9: 4.7u; generic_capc1005x50; voltage 6.3V; tolerance 20%; part_uid RP-019A1P-0C2GHY
J1: 10103594-0001LF; amphenol_10103594-0001lf; part_uid RP-019A1P-1JAX7V
J2, J3: TSW-118-07-L-D; samtec_tsw-118-07-l-d; part_uid RP-01JWH2-G371Y4
J4: SM03B-SRSS-TB(LF)(SN); jst_sm03b-srss-tb-lf--sn-; part_uid RP-01EKJ1-8V9SV1
L1: 3.3u; abracon_aota-b201610s3r3-101-t; tolerance 20%; part_uid RP-01GY5D-2VC7WP
MH1, MH2, MH3, MH4: NPTH FD2.75mm SM3.15mm KO6mm; none_mh_npth_fd2p75mm_sm3p15mm_ko6mm; part_uid RP-01HF5R-LCTEJS
PCB1: R4; manufacturer_pn XXX
R1: 10k; generic_resc1005x35; tolerance 1%; voltage 50V; part_uid RP-019A1P-53DHSX; not fitted
R2, R4, R6: 1k; generic_resc1005x35; tolerance 1%; voltage 50V; part_uid RP-019A1P-4Z6ZWY
R3: 33; generic_resc1005x35; tolerance 1%; voltage 50V; part_uid RP-019A1P-58PW9L
R7, R8: 27; generic_resc1005x35; tolerance 1%; voltage 50V; part_uid RP-01C89V-LTEYC4
R9: 0; generic_resc1005x35; tolerance +50mR; voltage 50V; part_uid RP-019A1P-4Y4V63; not fitted
R10: 0; generic_resc1005x35; tolerance +50mR; voltage 50V; part_uid RP-019A1P-4Y4V63
SBREV1: S1
SW1, SW2: 434133025816; wurthelek_434133025816; part_uid RP-01H0MT-6E9H8F
U1: RP2350A; rpi_rp2350a_vias; part_uid RP-01HA9H-9K5E8T
U2: NCP1117ST33T3G; onsemi_ncp1117st33t3g; voltage 3.3V; part_uid RP-01JWD9-7JRX6J
U3: W25Q128JVSIQ; generic_soic127p790x195-8; voltage 2.7-3.6V; part_uid RP-01JWD4-F1H4N9
VARIANT1: RPI-RP2350A-MINIMAL
X1: 12MHz; generic_xtalcc320x250x80-4; tolerance 30ppm; part_uid RP-01G8X7-GS352B

Connections:
+1V1: C7.1, C8.1, C10.1, C11.1, L1.1, U1.6 (DVDD), U1.23 (DVDD), U1.39 (DVDD), U1.50 (VREG_FB)
+3V3: C2.1, C5.1, C6.1, C12.1, C13.1, C14.1, C15.1, C16.1, C17.1, C18.1, C19.1, J2.2, R1.1, R3.1, U1.1 (IOVDD), U1.11 (IOVDD), U1.20 (IOVDD), U1.30 (IOVDD), U1.38 (IOVDD), U1.44 (ADC_AVDD), U1.45 (IOVDD), U1.49 (VREG_VIN), U1.53 (USB_OTP_VDD), U1.54 (QSPI_IOVDD), U2.2 (OUT), U2.4 (OUT), U3.8 (VCC)
/FLASH_SS: R1.2, R9.2, R10.2, U3.1 (~CS)
/GPIO0: J2.4, R9.1, U1.2 (GPIO0)
/GPIO1: J2.6, U1.3 (GPIO1)
/GPIO2: J2.8, U1.4 (GPIO2)
/GPIO3: J2.10, U1.5 (GPIO3)
/GPIO4: J2.12, U1.7 (GPIO4)
/GPIO5: J2.14, U1.8 (GPIO5)
/GPIO6: J2.16, U1.9 (GPIO6)
/GPIO7: J2.18, U1.10 (GPIO7)
/GPIO8: J2.20, U1.12 (GPIO8)
/GPIO9: J2.22, U1.13 (GPIO9)
/GPIO10: J2.24, U1.14 (GPIO10)
/GPIO11: J2.26, U1.15 (GPIO11)
/GPIO12: J2.28, U1.16 (GPIO12)
/GPIO13: J2.30, U1.17 (GPIO13)
/GPIO14: J2.32, U1.18 (GPIO14)
/GPIO15: J2.34, U1.19 (GPIO15)
/GPIO16: J3.27, U1.27 (GPIO16)
/GPIO17: J3.25, U1.28 (GPIO17)
/GPIO18: J3.23, U1.29 (GPIO18)
/GPIO19: J3.21, U1.31 (GPIO19)
/GPIO20: J3.19, U1.32 (GPIO20)
/GPIO21: J3.17, U1.33 (GPIO21)
/GPIO22: J3.15, U1.34 (GPIO22)
/GPIO23: J3.13, U1.35 (GPIO23)
/GPIO24: J3.11, U1.36 (GPIO24)
/GPIO25: J3.9, U1.37 (GPIO25)
/GPIO26_ADC0: J3.7, U1.40 (GPIO26_ADC0)
/GPIO27_ADC1: J3.5, U1.41 (GPIO27_ADC1)
/GPIO28_ADC2: J3.3, U1.42 (GPIO28_ADC2)
/GPIO29_ADC3: J3.1, U1.43 (GPIO29_ADC3)
/QSPI_SCLK: U1.56 (QSPI_SCLK), U3.6 (CLK)
/QSPI_SD0: U1.57 (QSPI_SD0), U3.5 (DI_IO0)
/QSPI_SD1: U1.59 (QSPI_SD1), U3.2 (DO_IO1)
/QSPI_SD2: U1.58 (QSPI_SD2), U3.3 (~WP_IO2)
/QSPI_SD3: U1.55 (QSPI_SD3), U3.7 (~HOLD_IO3)
/QSPI_SS: R6.1, R10.1, U1.60 (QSPI_~SS)
/RUN: J3.29, SW2.3, SW2.4, U1.26 (RUN)
/SWCLK: J3.33, J4.1, U1.24 (SWCLK)
/SWD: J3.31, J4.3, U1.25 (SWDIO)
/USB_D+: J1.3 (D+), R7.1
/USB_D-: J1.2 (D-), R8.1
/VREG_AVDD: C9.1, R3.2, U1.46 (VREG_AVDD)
/VREG_LX: L1.2, U1.48 (VREG_LX)
/XIN: C3.1, U1.21 (XIN), X1.1
/XOUT: R2.1, U1.22 (XOUT)
/~USB_BOOT: R6.2, SW1.3, SW1.4
GND: C1.2, C2.2, C3.2, C4.2, C5.2, C6.2, C7.2, C8.2, C9.2, C10.2, C11.2, C12.2, C13.2, C14.2, C15.2, C16.2, C17.2, C18.2, C19.2, J1.5 (GND), J1.6 (SH), J1.7 (SH), J1.8 (SH), J1.9 (SH), J1.10 (SH), J1.11 (SH), J2.1, J2.3, J2.5, J2.7, J2.9, J2.11, J2.13, J2.15, J2.17, J2.19, J2.21, J2.23, J2.25, J2.27, J2.29, J2.31, J2.33, J2.35, J2.36, J3.2, J3.4, J3.6, J3.8, J3.10, J3.12, J3.14, J3.16, J3.18, J3.20, J3.22, J3.24, J3.26, J3.28, J3.30, J3.32, J3.34, J3.35, J3.36, J4.2, J4.4 (SH1), J4.5 (SH2), R4.2, SW1.1, SW1.2, U1.47 (VREG_PGND), U1.61 (GND), U2.1 (GND), U3.4 (GND), X1.2, X1.4
unnamed: C4.1, R2.2, X1.3
unnamed: R4.1, SW2.1, SW2.2
unnamed: R8.2, U1.51 (USB_DM)
unnamed: R7.2, U1.52 (USB_DP)
VBUS: C1.1, J1.1 (VCC), U2.3 (IN)

Notes on the sheet:
JST Debug Connector
IOs
RUN Button
BOOTSEL Button
If using RP2354 (internal flash), remove R10. R9 can be fit to use U3 as secondary memory.
Flash
Note: S1 schematic revision indicates that this is the 1st revision of the schematic/BOM associated with the R4 PCB. R4-S1 therefore uniquely identifies the fully built PCB Assembly (PCBA). This is a change from the previous revision numbering to align with the internal Raspberry Pi product revisio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
Make sure R7 and R8 are close to RP2350
12MHz Crystal
Power

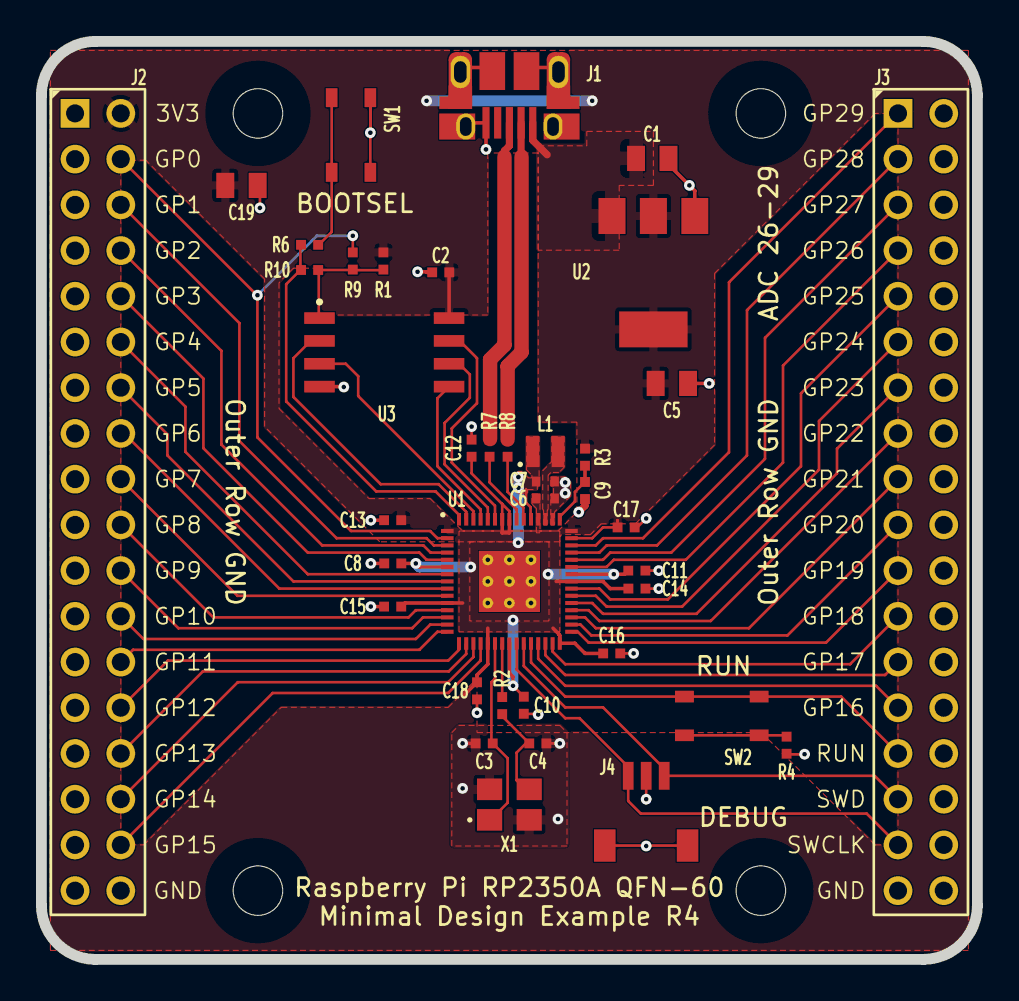
[picture p14: board RPI-RP2350A-MINIMAL_R4-S1.kicad_pcb from above]

Board: 2 copper layers, 52.0 x 51.0 mm, 43 parts (0 on the bottom side), 55 nets.
