HSBL-ko-gyo/WING27/(commit log)

2026-10-17 Preserve WING27 sources and verified P2 switch placement
    [WING27.kicad_pcb, WING27.kicad_sch, WING27_BOM.csv, Wing27_P2_60_key_center_coordinates_mm.csv, Wing27_P2_60_key_centers_mm.dxf, Wing27_P2_reference_plate_T1_D1_60_centers.step]
2026-10-17 Complete WING27 electrical design and verified footprints before routing
    [Controller.kicad_sch, RPI-RP2350A-MINIMAL_R4-S1.kicad_pcb, RPI-RP2350A-MINIMAL_R4-S1.kicad_sch, WING27.kicad_pcb, WING27.kicad_sch, WING27_BOM.csv, WING27_key_matrix.csv]
2026-10-17 Add KiCanvas schematic and PCB viewer link
2026-10-17 Refine WING27 schematics, SWD connector, panel overlay and mounting
    [Controller.kicad_sch, WING27.kicad_pcb, WING27.kicad_sch, WING27_BOM.csv]
2026-10-17 Split keyboard GPIO banks and refine basic parts and SWD options
    [Controller.kicad_sch, WING27.kicad_pcb, WING27.kicad_sch, WING27_BOM.csv, WING27_key_matrix.csv]
2026-10-17 Arrange controller schematic from USB and power to MCU
    [Controller.kicad_sch]
2026-10-17 Add side LEDs and preserve verified official core routing
    [Controller.kicad_sch, LEDs.kicad_sch, WING27.kicad_pcb, WING27.kicad_sch, WING27_BOM.csv]
